capotostobnl/cc-afe-hw/assembly/psc_carrier_brd_BOM.ods

zuPSC Carrier Board
Parts Per Board |  | 216
Total Parts Cost |  | $304.54
Line Number | Qty per Board | Unit Cost | Cost Per Board | Part Number | Reference | Value | Description | Manufacturer
1 | 4 | $6.06 | $24.24 | LT3045EDD#TRPBF | U7,U8,U9,U10 |  | IC REG LIN POS ADJ 500MA 10DFN | Analog Devices
2 | 4 | $2.01 | $8.04 | LT6106CS5#TRMPBF | U4,U5,U21,U22 |  | IC CURR SENSE 1 CIRCUIT TSOT23-5 | Analog Devices
3 | 2 | $6.46 | $12.92 | LT3015EQ-15#PBF | U3,U20 |  | IC REG LINEAR -15V 1.5A DDPAK-5 | Analog Devices
4 | 2 | $5.57 | $11.14 | LT1963AEQ#TRPBF | U2,U19 |  | IC REG LIN POS ADJ 1.5A DDPAK-5 | Analog Devices
5 | 4 | $0.00 | $0.00 | BNL | U15,U16,U17,U18 |  | Burden Resistor Daughterboard | BNL
6 | 3 | $9.38 | $28.14 | LTC2991CMS#TRPBF | U12,U13,U14 |  | IC MONITOR OCTAL 16MSOP | Analog Devices
7 | 1 | $0.37 | $0.37 | CD74HC4050PWR | U23 |  | IC BUFFER NON-INVERT 6V 16-TSSOP | TI
8 | 1 | $9.56 | $9.56 | LT8643SEV#PBF | U11 |  | IC REG BUCK ADJ 6A 24LQFN | Analog Devices
9 | 1 | $5.79 | $5.79 | LT3015EDD#PBF | U6 |  | IC REG LINEAR NEG ADJ 1.5A 8-DFN | Analog Devices
10 | 1 | $1.78 | $1.78 | 3-641215-6 | U1 |  | CONN HEADER VERT 6POS 2.54MM | TE
11 | 8 | $0.23 | $1.84 | RCS-0C | TP12,TP13,TP14,TP15,TP16,TP17,TP18,TP19 |  | PC TEST POINT NATURAL | TE
12 | 11 | $0.00 | $0.00 | N/A | TP1,TP2,TP3,TP4,TP5,TP6,TP7,TP8,TP9,TP10,TP11 |  | TEST POINT | N/A
13 | 6 | $0.01 | $0.06 | ERJ-2RKF4991X | R9,R10,R48,R49,R58,R59 | 4.99K | RES SMD 4.99K OHM 1% 1/10W 0402 | Panasonic
14 | 11 | $0.01 | $0.11 | ERJ-2RKF1002X | R60,R61,R62,R63,R64,R65,R66,R67,R68,R69,R70 | 10K | RES SMD 9.53K OHM 1% 1/10W 0402 | Panasonic
15 | 3 | $0.01 | $0.03 | ERJ-2RKF9531X | R42,R44,R46 | 9.53K | RES SMD 9.53K OHM 1% 1/10W 0402 | Panasonic
16 | 4 | $0.71 | $2.84 | KRL6432E-M-R010-F-T1 | R4,R7,R53,R56 | 0.01 | RES 0.01 OHM 3W 2512 WIDE | Susumu
17 | 6 | $0.01 | $0.06 | ERJ-2RKF9091X | R36,R38,R40,R43,R45,R47 | 9.09K | RES SMD 9.09K OHM 1% 1/10W 0402 | Panasonic
18 | 2 | $0.01 | $0.02 | ERJ-2RKF4701X | R31,R32 | 4.7K | RES SMD 4.7K OHM 1% 1/10W 0402 | Panasonic
19 | 8 | $0.01 | $0.08 | ERJ-2RKF1000X | R3,R5,R6,R8,R52,R54,R55,R57 | 100 | RES SMD 100 OHM 1% 1/10W 0402 | Panasonic
20 | 2 | $0.01 | $0.02 | ERJ-2RKF1022X | R29,R35 | 10.2K | RES SMD 10.2K OHM 1% 1/10W 0402 | Panasonic
21 | 7 | $0.01 | $0.07 | ERJ-2RKF1001X | R2,R16,R27,R37,R39,R41,R51 | 1.0K | RES SMD 1K OHM 1% 1/10W 0402 | Panasonic
22 | 5 | $0.38 | $1.90 | KRL2012E-M-R220-F-T5 | R13,R14,R19,R22,R25 | 0.22 | RES 0.22 OHM 1W 0805 WIDE | Susumu
23 | 5 | $0.01 | $0.05 | ERJ-2GE0R00X | R11,R17,R20,R23,R33 | 0 | RES SMD 0 OHM JUMPER 1/10W 0402 | Panasonic
24 | 3 | $0.01 | $0.03 | ERJ-2RKF1152X | R1,R15,R50 | 11.5K | ERJ-2RKF1152X | Panasonic
25 | 1 | $0.01 | $0.01 | ERJ-2RKF1600X | R71 | 160 | RES SMD 160 OHM 1% 1/10W 0402 | Panasonic
26 | 1 | $0.01 | $0.01 | ERJ-2RKF4222X | R34 | 42.2K | RES SMD 42.2K OHM 1% 1/10W 0402 | Panasonic
27 | 1 | $0.01 | $0.01 | ERJ-2RKF1131X | R30 | 1.13K | RES SMD 1.13K OHM 1% 1/10W 0402 | Panasonic
28 | 1 | $0.01 | $0.01 | ERJ-2RKF8451X | R28 | 8.45K | RES SMD 8.45K OHM 1% 1/10W 0402 | Panasonic
29 | 1 | $0.01 | $0.01 | ERJ-2RKF4122X | R26 | 41.2K | RES SMD 41.2K OHM 1% 1/10W 0402 | Panasonic
30 | 1 | $0.01 | $0.01 | ERJ-2RKF2492X | R24 | 24.9K | RES SMD 24.9K OHM 1% 1/10W 0402 | Panasonic
31 | 1 | $0.01 | $0.01 | ERJ-2RKF1802X | R21 | 18.0K | RES SMD 18K OHM 1% 1/10W 0402 | Panasonic
32 | 1 | $0.01 | $0.01 | ERJ-2RKF3322X | R18 | 33.2K | RES SMD 33.2K OHM 1% 1/10W 0402 | Panasonic
33 | 1 | $0.01 | $0.01 | ERJ-2RKF5362X | R12 | 53.6K | RES SMD 53.6K OHM 1% 1/10W 0402 | Panasonic
34 | 1 | $0.10 | $0.10 | NX7002BKWX | Q1 |  | MOSFET N-CH 60V 270MA SOT323 | Nexperia
35 | 5 | $0.01 | $0.05 | LSMGG160808T331RG | L1,L2,L3,L4,L5 |  | FERRITE BEAD 330 OHM 0603 1LN | Taiyo Yuden
36 | 1 | $3.26 | $3.26 | MSS1048-222NLC | L6 | 2.2uF | FIXED IND 2.2UH 9.78A 7.2MOHM SM | Coilcraft
37 | 4 | $17.82 | $71.28 | 836149012 | J8,J11,J14,J17 |  | CONN MICRO-D PLUG 25POS R/A SLDR | Molex
38 | 8 | $2.81 | $22.48 | 61083-061402LF | J5,J6,J9,J10,J12,J13,J15,J16 |  | CONN PLUG 60POS SMD GOLD | Amphenol
39 | 3 | $17.37 | $52.11 | 6469028-1 | J1,J2,J3 |  | CONN RCPT HIGH SPEED 60P EDGE MT | TE
40 | 1 | $24.50 | $24.50 | 1731130154 | J7 |  | CONN D-SUB HD PLG 26POS R/A SLDR | Molex
41 | 1 | $1.25 | $1.25 | 39301022 | J4 |  | CONN HEADER R/A 2POS | Molex
42 | 2 | $0.77 | $1.54 | ASMDC300F/24-2 | F1,F2 |  | PTC RESET FUSE 24V 3A 2SMD | Littlefuse
43 | 2 | $0.10 | $0.20 | LTST-C191KGKT | D1,D3 | GREEN | LED GREEN CLEAR SMD | Lite-On Inc.
44 | 4 | $3.56 | $14.24 | T521X107M025ATE060 | C7,C8,C66,C67 | 100uF | CAP TANT POLY 100UF 25V 2917 | Kemet
45 | 4 | $0.04 | $0.16 | CL21A226MAYNNNE | C53,C54,C55,C56 | 22uF | CAP CER 22UF 25V X5R 0805 | Samsung
46 | 28 | $0.01 | $0.28 | TMK105BJ104KV-F | C5,C6,C10,C12,C13,C14,C15,C19,C21,C23,C24,C30,C31,C36,C37,C42,C43,C57,C58,C59,C64,C65,C69,C71,C72,C73,C74,C75 | 0.1uF | CAP CER 0.1UF 25V X5R 0402 | Taiyo Yuden
47 | 2 | $0.01 | $0.02 | CL10C100JB8NFNC | C48,C52 | 10pF | CAP CER 10PF 50V C0G/NP0 0603 | Samsung
48 | 25 | $0.04 | $1.00 | CL10A106MA8NRNC | C3,C4,C9,C11,C16,C17,C18,C20,C22,C25,C28,C29,C32,C34,C35,C38,C40,C41,C44,C47,C49,C62,C63,C68,C70 | 10uF | CAP CER 10UF 25V X5R 0603 | Samsung
49 | 5 | $0.22 | $1.10 | GRM31CR61A107MEA8L | C26,C27,C33,C39,C45 | 100uF | CAP CER 100UF 10V X5R 1206 | Murata
50 | 4 | $0.44 | $1.76 | EEE-FTH101XAP | C1,C2,C60,C61 | 100uF | CAP ALUM 100UF 20% 50V SMD | Panasonic
51 | 1 | $0.01 | $0.01 | CL10B105KA8NNNC | C51 | 1uF | CAP CER 1UF 25V X7R 0603 | Samsung
52 | 1 | $0.01 | $0.01 | CL10B331KB8NNNC | C50 | 330pF | CAP CER 330PF 50V X7R 0603 | Samsung
53 | 1 | $0.01 | $0.01 | CL10B223KB8NNNC | C46 | 0.022uF | CAP CER 0.022UF 50V X7R 0603 | Samsung
