capotostobnl/cc-afe-hw/3dmodels/ADR3425ARJZ-R2.step

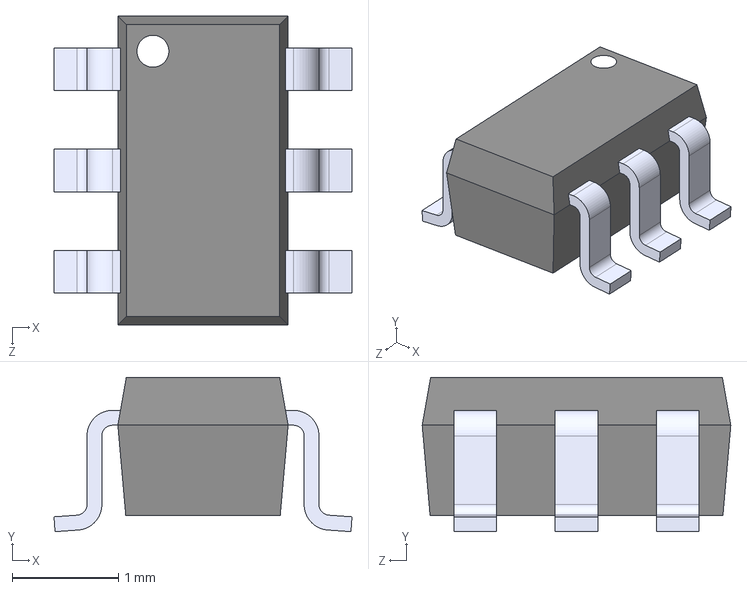
[picture p1: CAD file, 2026-06-05]
3dmodels/ADR3425ARJZ-R2.step
2.80 x 1.45 x 2.90 mm
