capotostobnl/cc-afe-hw/3dmodels/c-1625854-1-ba-3d.step

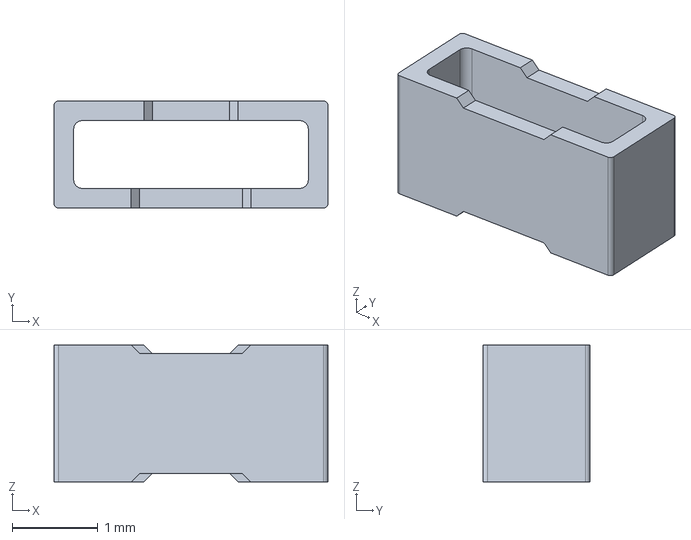
[picture p3: CAD file, 2026-06-02]
3dmodels/c-1625854-1-ba-3d.step
3.20 x 1.25 x 1.60 mm
