capotostobnl/cc-afe-hw/3dmodels/KRL2012E-M-R220-F-T5.step

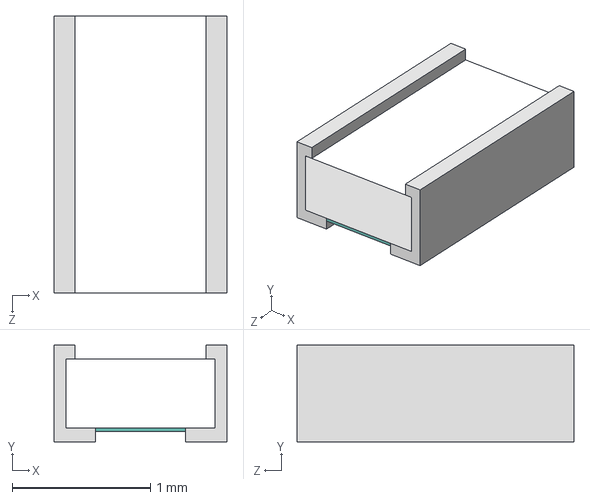
[picture p5: CAD file, 2026-06-02]
3dmodels/KRL2012E-M-R220-F-T5.step
1.25 x 0.7 x 2.00 mm
