capotostobnl/cc-afe-hw/3dmodels/SN74LVC16T245DGGR.STEP

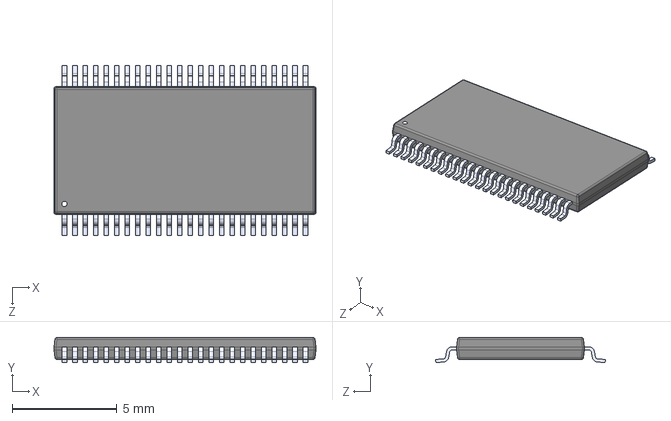
[picture p6: CAD file, 2026-06-02]
3dmodels/SN74LVC16T245DGGR.STEP
12.5 x 1.20 x 8.10 mm
