capotostobnl/cc-afe-hw/3dmodels/0875-1G2T-E3.STEP

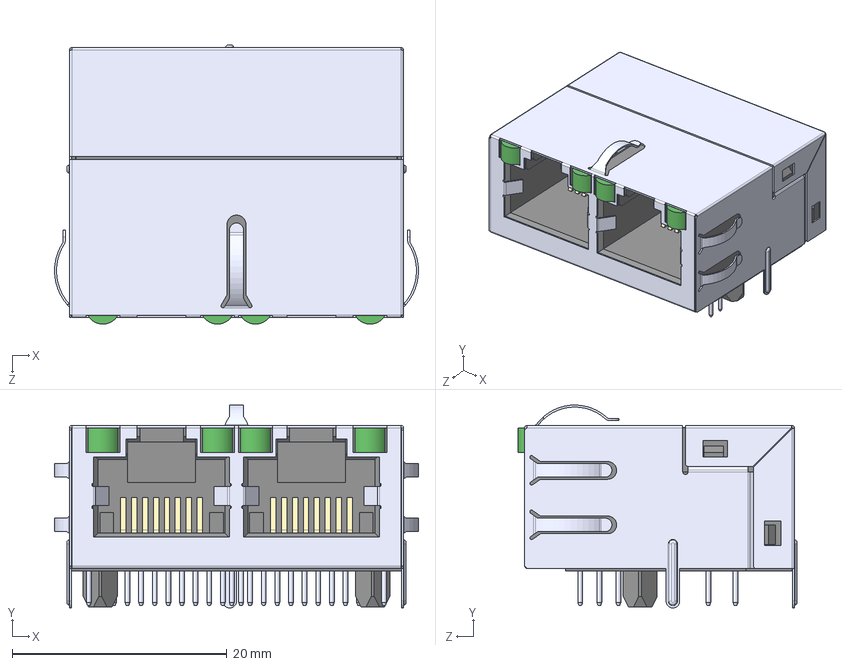
[picture p7: CAD file, 2026-06-02]
3dmodels/0875-1G2T-E3.STEP
33.9 x 18.9 x 26.0 mm
