capotostobnl/cc-afe-hw/3dmodels/TPS3850H33DRCR.STEP

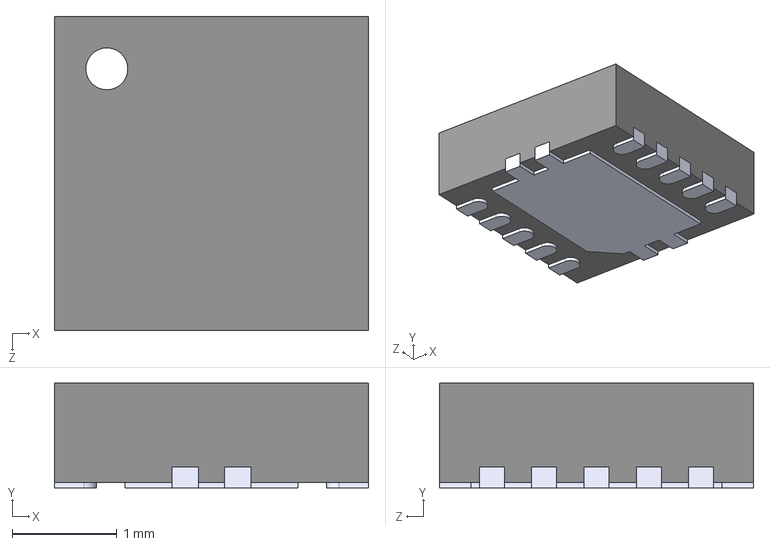
[picture p8: CAD file, 2026-06-02]
3dmodels/TPS3850H33DRCR.STEP
3.00 x 1.00 x 3.00 mm
