capotostobnl/cc-afe-hw/3dmodels/LTC2991CMS_TRPBF.step

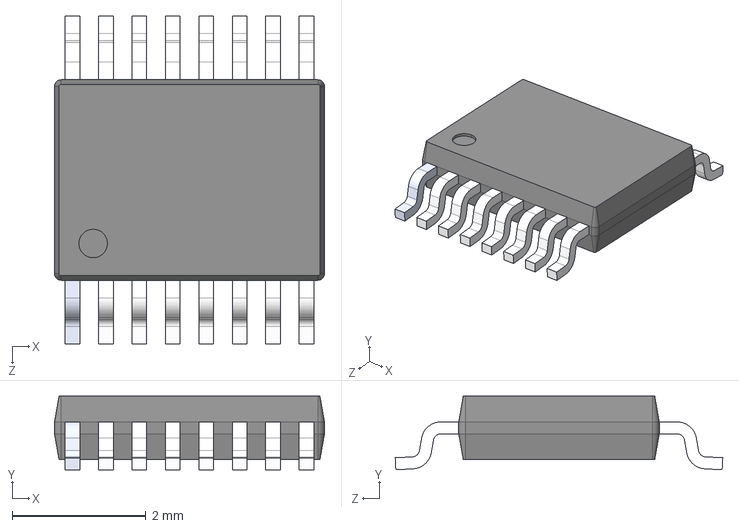
[picture p9: CAD file, 2026-06-02]
3dmodels/LTC2991CMS_TRPBF.step
4.04 x 1.10 x 4.90 mm
