capotostobnl/cc-afe-hw/3dmodels/LEMO_EPY_00_250_NTN.stp

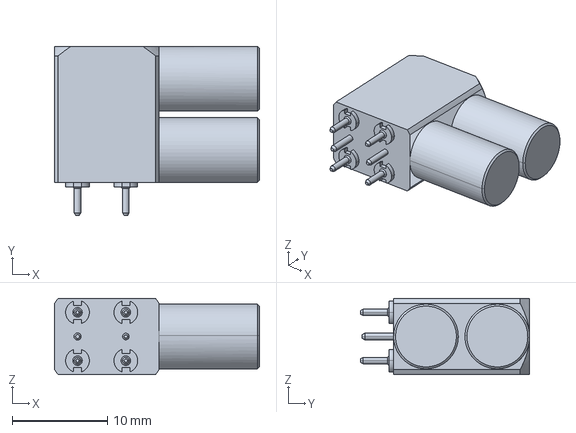
[picture p10: CAD file, 2026-06-02]
3dmodels/LEMO_EPY_00_250_NTN.stp
21.6 x 17.8 x 8.00 mm
