capotostobnl/cc-afe-hw/3dmodels/CB3LV-3I-25M0000.step

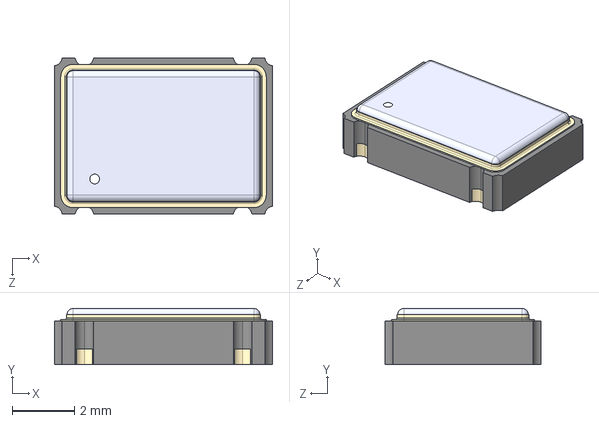
[picture p11: CAD file, 2026-06-02]
3dmodels/CB3LV-3I-25M0000.step
7.00 x 1.80 x 5.00 mm
