capotostobnl/cc-afe-hw/3dmodels/RES_6432_SUS.step

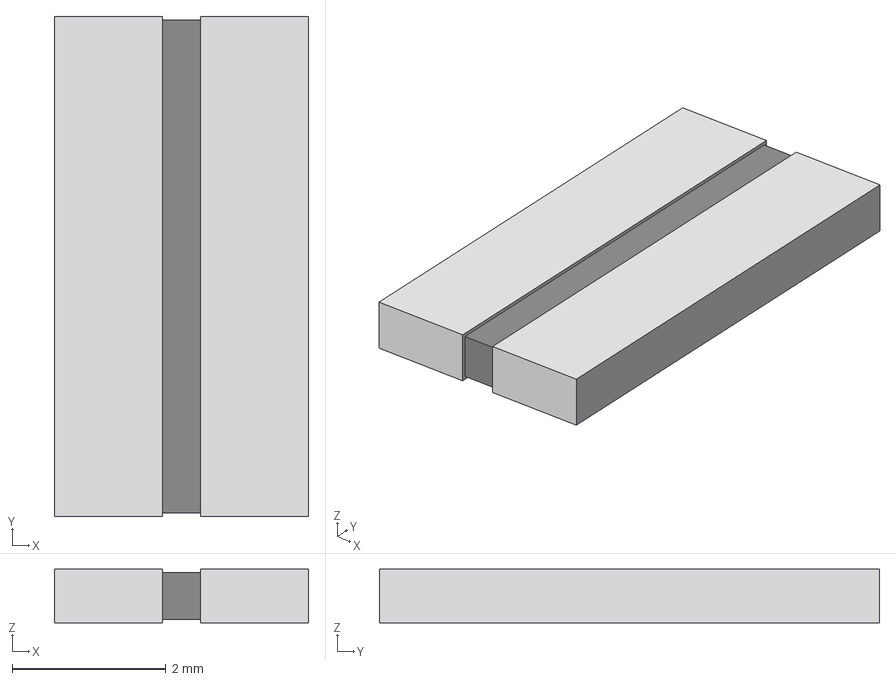
[picture p12: CAD file, 2026-06-02]
3dmodels/RES_6432_SUS.step
3.30 x 6.50 x 0.7 mm
