capotostobnl/cc-afe-hw/3dmodels/MSOP-8_MS_LIT.step

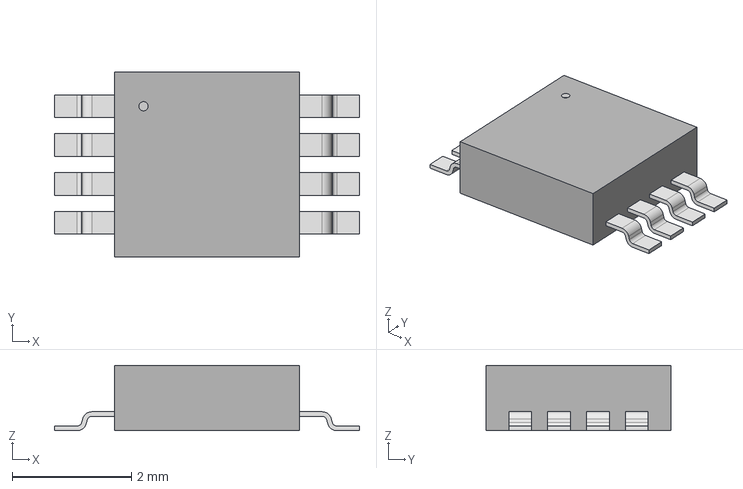
[picture p13: CAD file, 2026-06-02]
3dmodels/MSOP-8_MS_LIT.step
5.11 x 3.10 x 1.09 mm
