capotostobnl/cc-afe-hw/3dmodels/SN74LVC8T245DWR.step

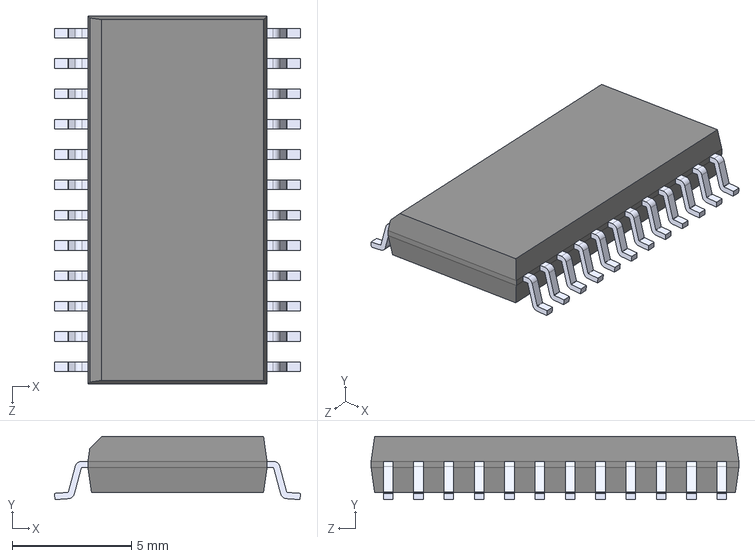
[picture p14: CAD file, 2026-06-02]
3dmodels/SN74LVC8T245DWR.step
10.3 x 2.65 x 15.4 mm
