capotostobnl/cc-afe-hw/3dmodels/3-641215-6-z-3d.step

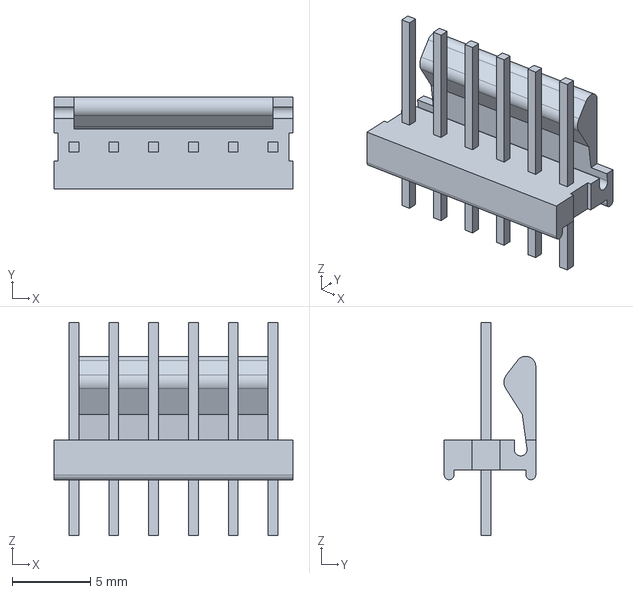
[picture p15: CAD file, 2026-06-02]
3dmodels/3-641215-6-z-3d.step
15.2 x 5.84 x 13.6 mm
