capotostobnl/cc-afe-hw/3dmodels/Coilcraft-MSS1048.step

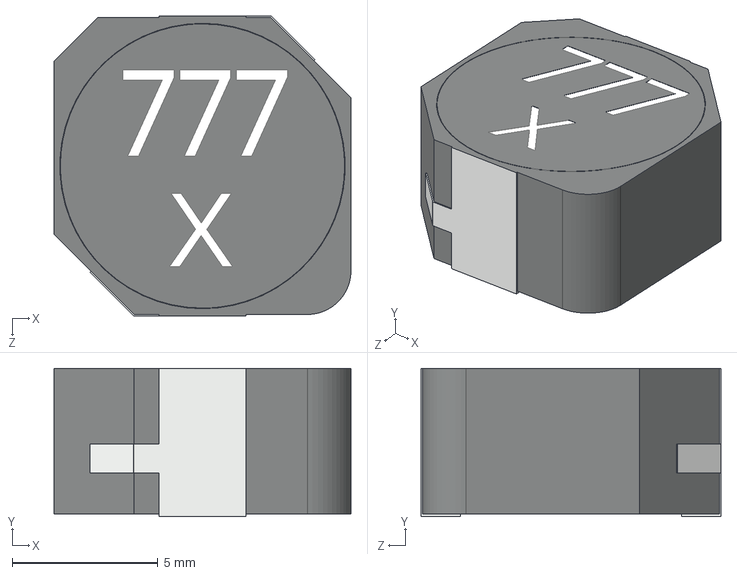
[picture p16: CAD file, 2026-06-02]
3dmodels/Coilcraft-MSS1048.step
10.2 x 5.10 x 10.3 mm
