capotostobnl/cc-afe-hw/3dmodels/Amphenol_10090926-P264XLF.step

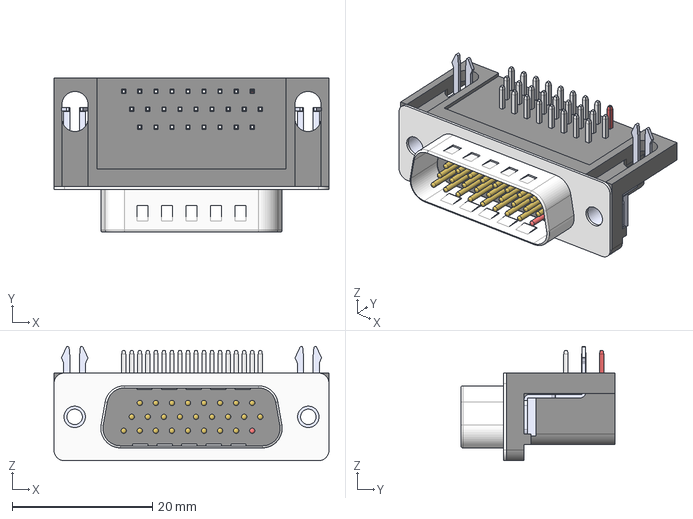
[picture p17: CAD file, 2026-06-02]
3dmodels/Amphenol_10090926-P264XLF.step
39.2 x 22.0 x 16.3 mm
