capotostobnl/cc-afe-hw/3dmodels/RDM0023A.stp

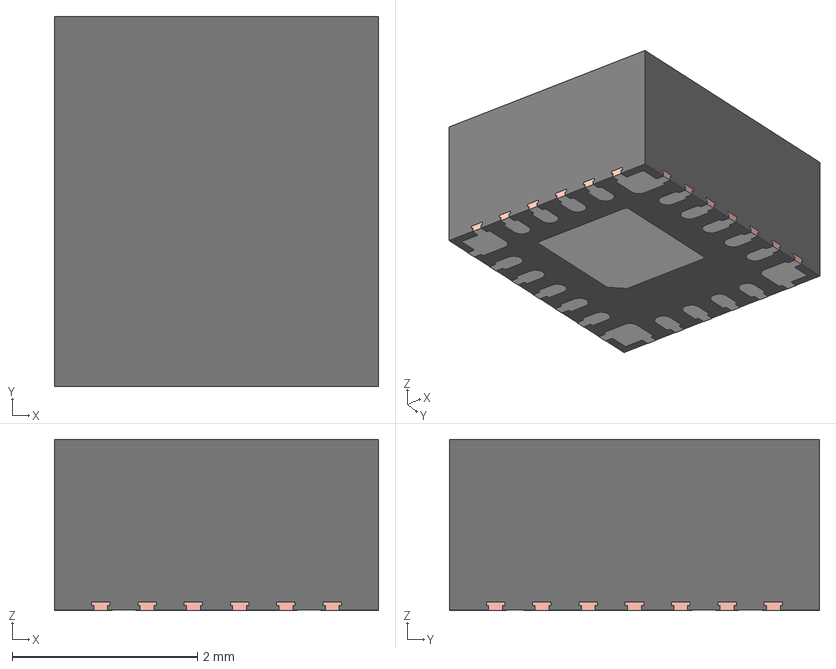
[picture p18: CAD file, 2026-06-02]
3dmodels/RDM0023A.stp
3.50 x 4.00 x 1.85 mm
FRAME
MOLD
