capotostobnl/cc-afe-hw/3dmodels/T521X107M025ATE060.step

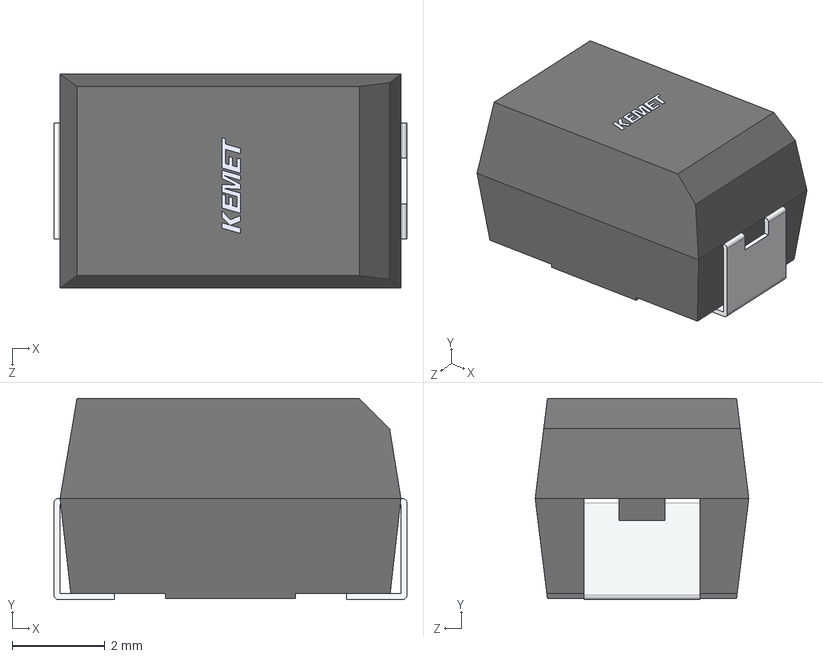
[picture p19: CAD file, 2026-06-02]
3dmodels/T521X107M025ATE060.step
7.60 x 4.34 x 4.60 mm
