capotostobnl/cc-afe-hw/3dmodels/ECS-LVDS33-2000-BN.STEP

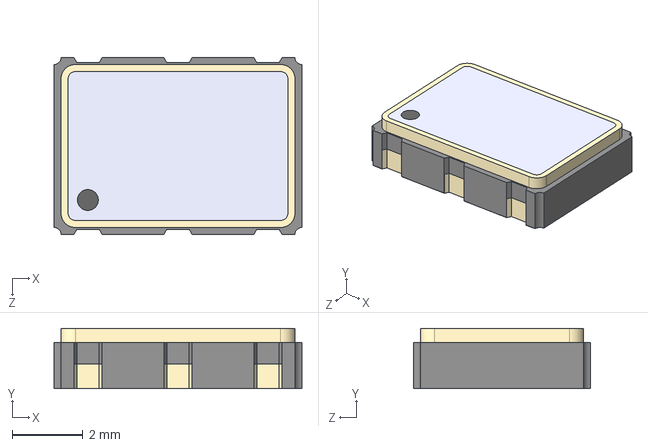
[picture p20: CAD file, 2026-06-02]
3dmodels/ECS-LVDS33-2000-BN.STEP
7.00 x 1.70 x 5.00 mm
