capotostobnl/cc-afe-hw/3dmodels/TPS7A8500RGRT.STEP

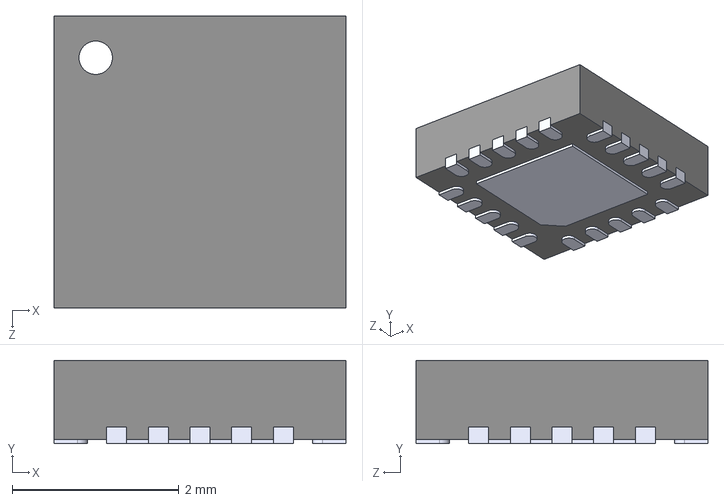
[picture p21: CAD file, 2026-06-02]
3dmodels/TPS7A8500RGRT.STEP
3.50 x 1.00 x 3.50 mm
