capotostobnl/cc-afe-hw/3dmodels/LT3015EDDPBF.step

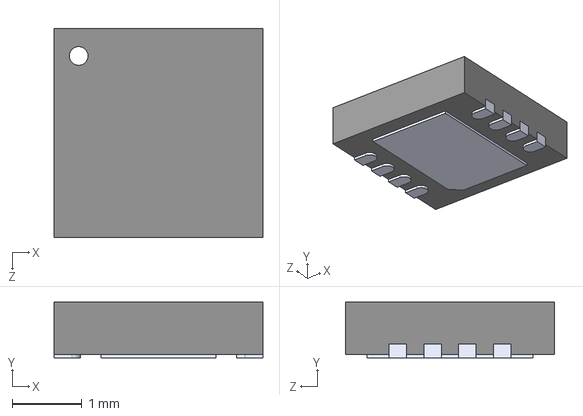
[picture p22: CAD file, 2026-06-02]
3dmodels/LT3015EDDPBF.step
3.00 x 0.8 x 3.00 mm
