capotostobnl/cc-afe-hw/3dmodels/PW0016A.step

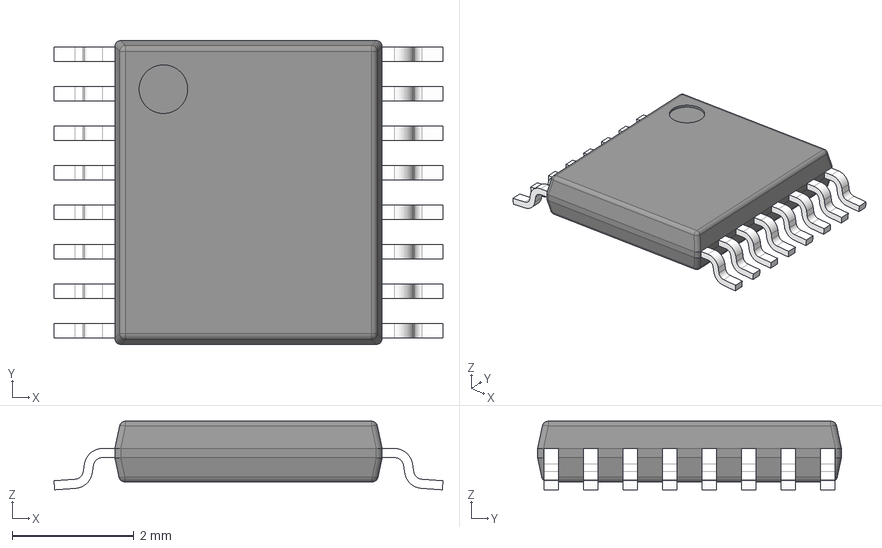
[picture p23: CAD file, 2026-06-02]
3dmodels/PW0016A.step
6.40 x 5.00 x 1.13 mm
BODY-TSSOP
LEAD-TSSOP x 16
PIN1
