capotostobnl/cc-afe-hw/3dmodels/IND_LSMG_160808_TAY.step

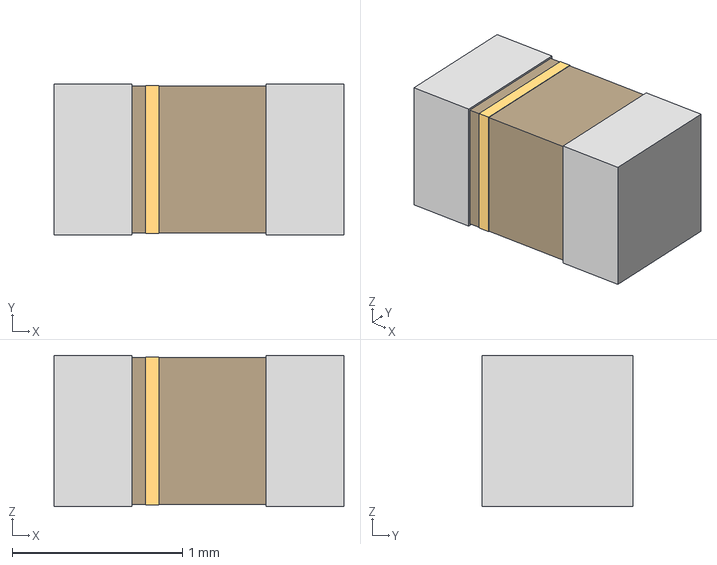
[picture p24: CAD file, 2026-06-02]
3dmodels/IND_LSMG_160808_TAY.step
1.70 x 0.888 x 0.889 mm
