capotostobnl/cc-afe-hw/3dmodels/AD5754BREZ.STEP

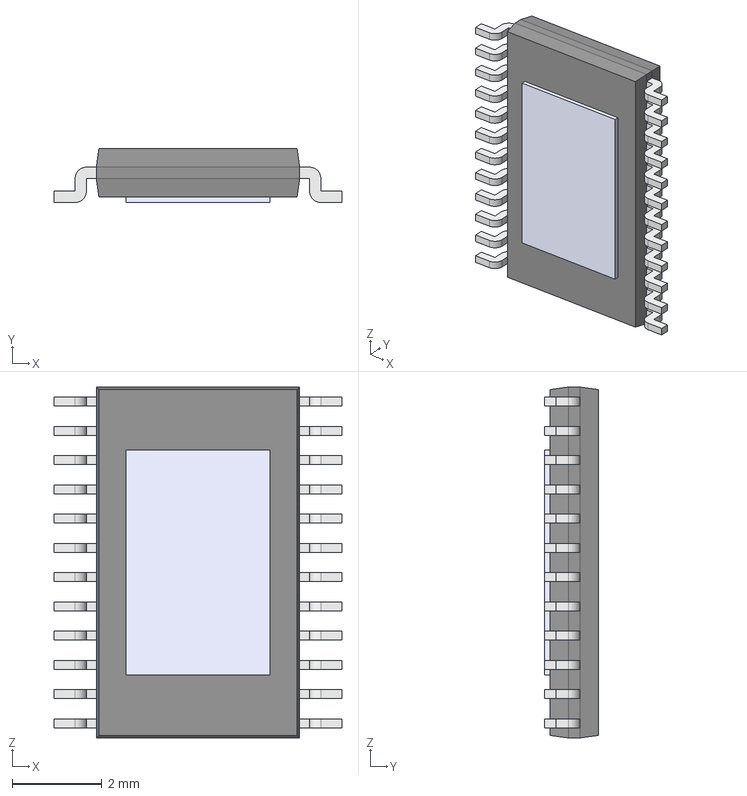
[picture p25: CAD file, 2026-06-02]
3dmodels/AD5754BREZ.STEP
6.40 x 1.20 x 7.80 mm
Body001 (Mirror #1) x 12
XY-plane x 12
X-axis x 12
