capotostobnl/cc-afe-hw/cc-afe.kicad_pcb

## KiCad design cc-afe.kicad_pcb (2026-06-05)

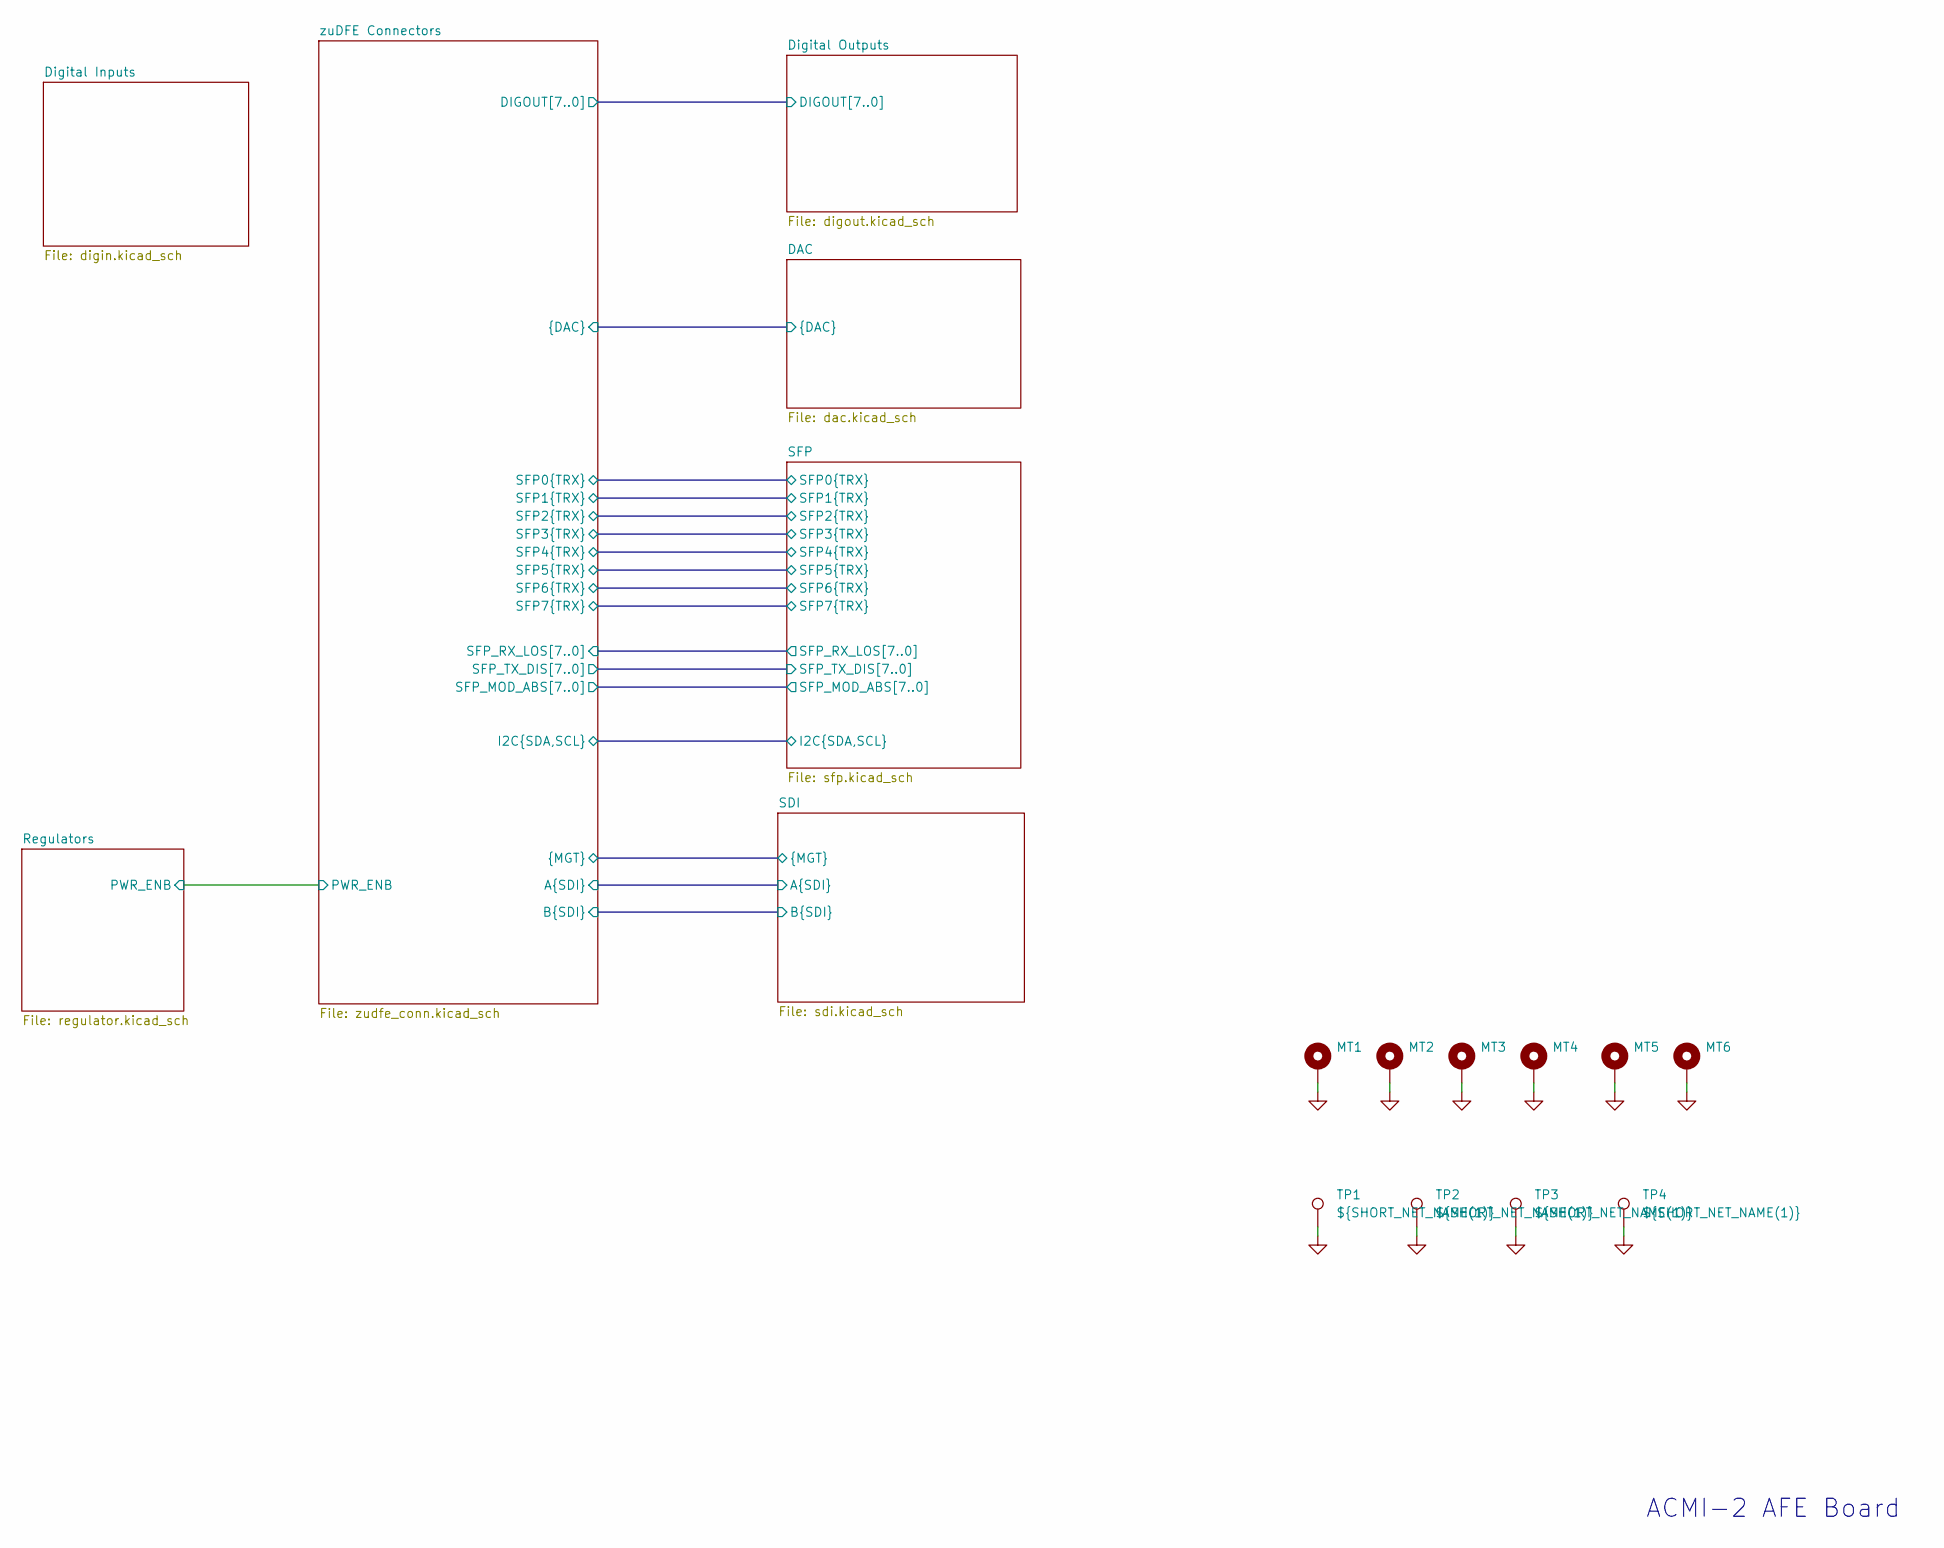
[picture p26: schematic cc-afe.kicad_sch]

Parts:
MT1, MT2, MT3, MT4, MT5, MT6: MountingHole_Pad; MountingHole_4.3mm_M4_DIN965_Pad
TP1, TP2, TP3, TP4: ${SHORT_NET_NAME(1)}; TestPoint_RCS-0C; MFG_PN RCS-0C

Connections:
GND: MT1.1, MT2.1, MT3.1, MT4.1, MT5.1, MT6.1, TP1.1, TP2.1, TP3.1, TP4.1; also elsewhere on the board

Notes on the sheet:
ACMI-2 AFE Board

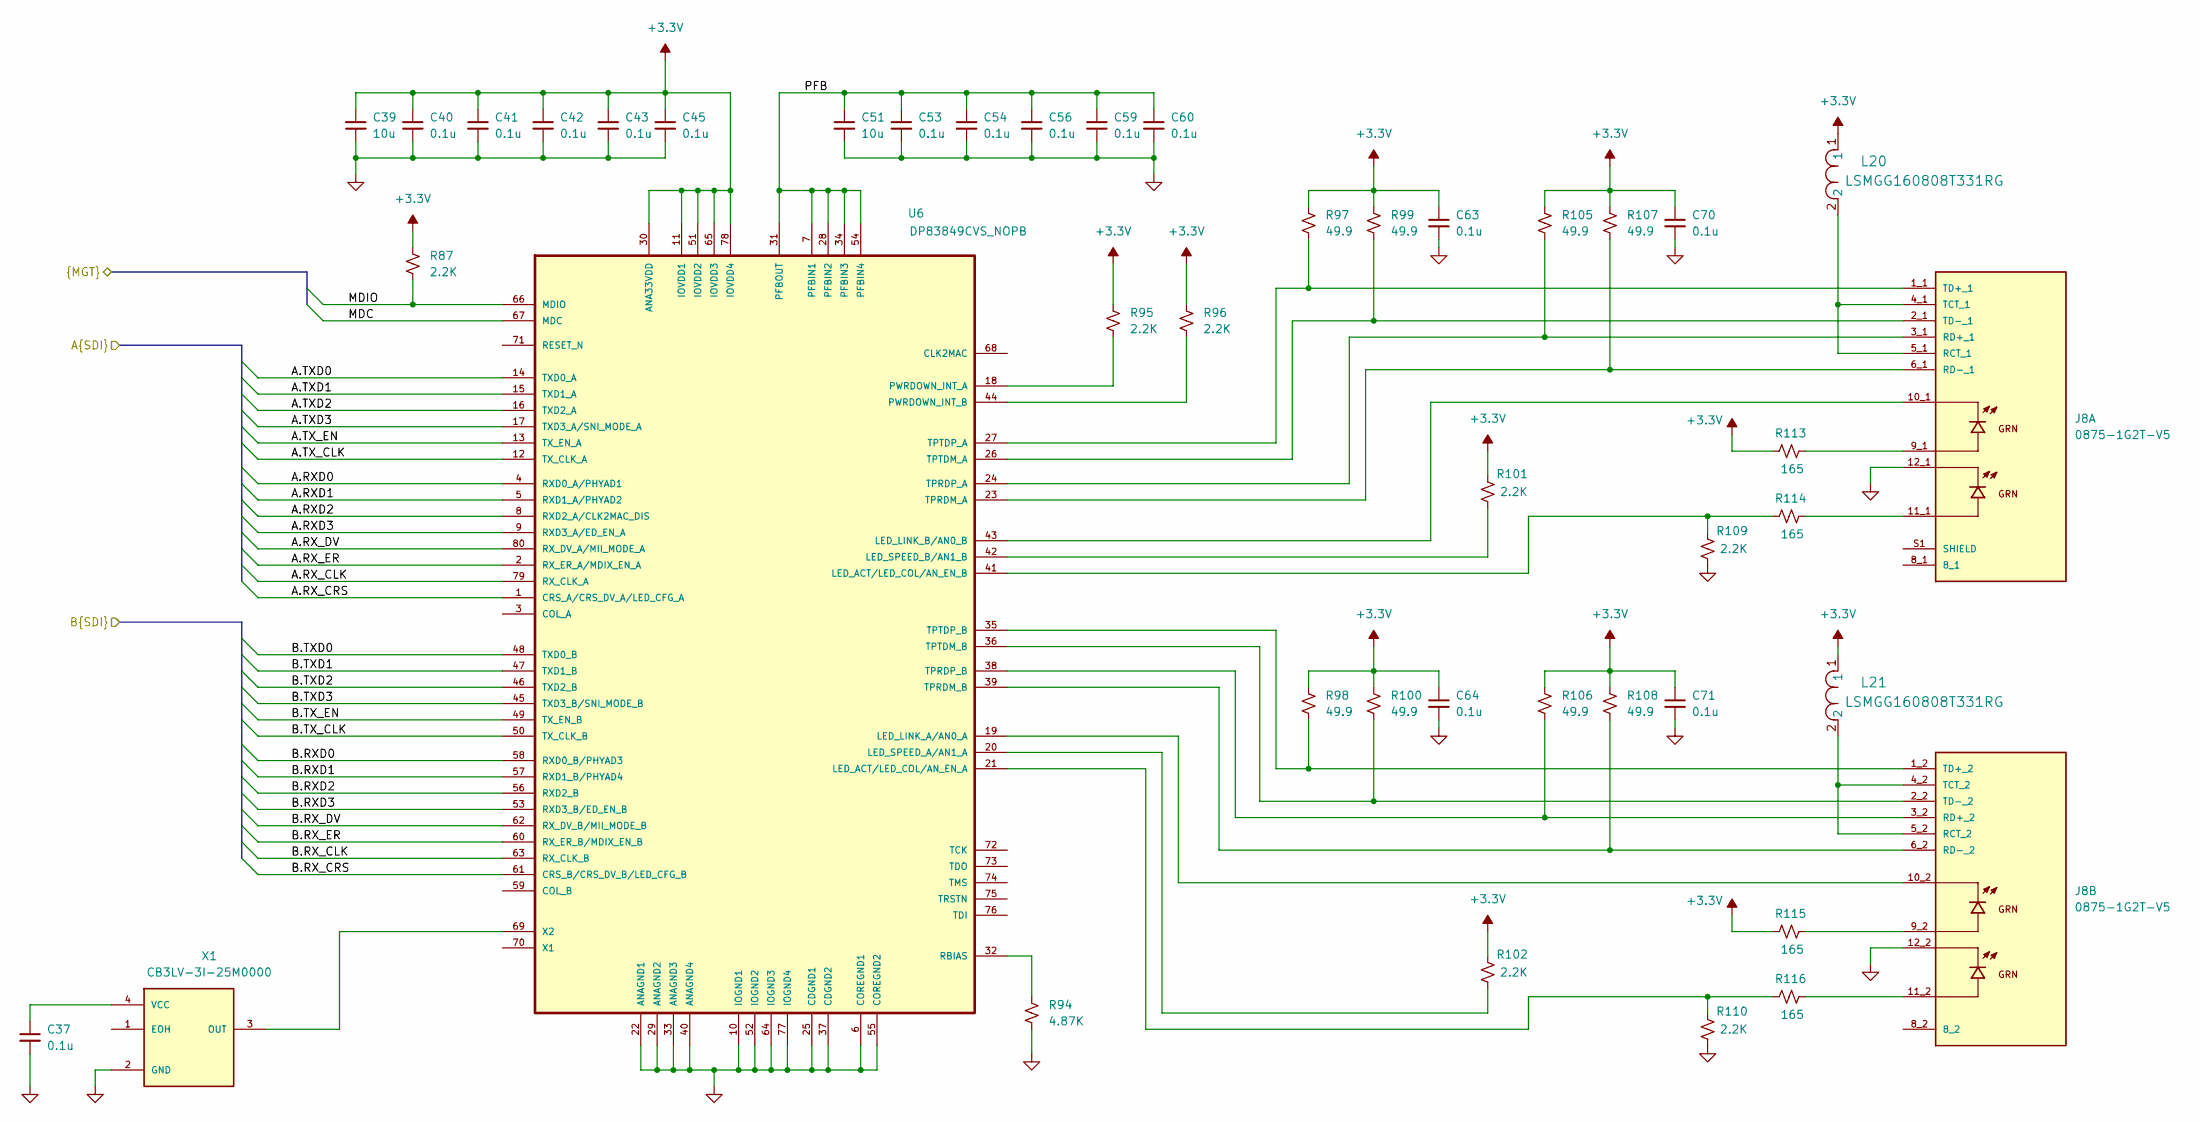
[picture p27: schematic sdi.kicad_sch]

Parts:
C37, C40, C41, C42, C43, C45, C53, C54, C56, C59, C60, C63, C64, C70, C71: 0.1u; C_0603_1608Metric; Voltage 50; MFG_PN GCJ188R71H104KA12D
C39, C51: 10u; C_0805_2012Metric; MFG_PN GRM21BR61C106KE15K
J8: 0875-1G2T-V5; BEL_0875-1G2T-V5
L20, L21: LSMGG160808T331RG; IND_LSMG_160808_TAY; MFG_PN LSMGG160808T331RG
R87, R95, R96: 2.2K; R_0603_1608Metric; MFG_PN ERJ-3EKF49R9V
R94: 4.87K; R_0603_1608Metric
R97, R98, R99, R100, R105, R106, R107, R108: 49.9; R_0603_1608Metric; MFG_PN ERJ-3EKF49R9V
R101, R102, R109, R110: 2.2K; R_0603_1608Metric
R113, R114, R115, R116: 165; R_0603_1608Metric
U6: DP83849CVS_NOPB; QFP50P1400X1400X120-80N; MFG_PN DP83849CVS/NOPB
X1: CB3LV-3I-25M0000; OSCCC700X500X180-4N; MFG_PN CB3LV-3I-25M0000

Connections:
+3.3V: C39.1, C40.1, C41.1, C42.1, C43.1, C45.1, C63.1, C64.1, C70.1, C71.1, L20.1, L21.1, R87.1, R95.1, R96.1, R97.1, R98.1, R99.1, R100.1, R101.2, R102.2, R105.1, R106.1, R107.1, R108.1, R113.1, R115.1, U6.11 (IOVDD1), U6.30 (ANA33VDD), U6.51 (IOVDD2), U6.65 (IOVDD3), U6.78 (IOVDD4); also elsewhere on the board
/SDI/A.RXD0: U6.4 (RXD0_A/PHYAD1); also elsewhere on the board
/SDI/A.RXD1: U6.5 (RXD1_A/PHYAD2); also elsewhere on the board
/SDI/A.RXD2: U6.8 (RXD2_A/CLK2MAC_DIS); also elsewhere on the board
/SDI/A.RXD3: U6.9 (RXD3_A/ED_EN_A); also elsewhere on the board
/SDI/A.RX_CLK: U6.79 (RX_CLK_A); also elsewhere on the board
/SDI/A.RX_CRS: U6.1 (CRS_A/CRS_DV_A/LED_CFG_A); also elsewhere on the board
/SDI/A.RX_DV: U6.80 (RX_DV_A/MII_MODE_A); also elsewhere on the board
/SDI/A.RX_ER: U6.2 (RX_ER_A/MDIX_EN_A); also elsewhere on the board
/SDI/A.TXD0: U6.14 (TXD0_A); also elsewhere on the board
/SDI/A.TXD1: U6.15 (TXD1_A); also elsewhere on the board
/SDI/A.TXD2: U6.16 (TXD2_A); also elsewhere on the board
/SDI/A.TXD3: U6.17 (TXD3_A/SNI_MODE_A); also elsewhere on the board
/SDI/A.TX_CLK: U6.12 (TX_CLK_A); also elsewhere on the board
/SDI/A.TX_EN: U6.13 (TX_EN_A); also elsewhere on the board
/SDI/B.RXD0: U6.58 (RXD0_B/PHYAD3); also elsewhere on the board
/SDI/B.RXD1: U6.57 (RXD1_B/PHYAD4); also elsewhere on the board
/SDI/B.RXD2: U6.56 (RXD2_B); also elsewhere on the board
/SDI/B.RXD3: U6.53 (RXD3_B/ED_EN_B); also elsewhere on the board
/SDI/B.RX_CLK: U6.63 (RX_CLK_B); also elsewhere on the board
/SDI/B.RX_CRS: U6.61 (CRS_B/CRS_DV_B/LED_CFG_B); also elsewhere on the board
/SDI/B.RX_DV: U6.62 (RX_DV_B/MII_MODE_B); also elsewhere on the board
/SDI/B.RX_ER: U6.60 (RX_ER_B/MDIX_EN_B); also elsewhere on the board
/SDI/B.TXD0: U6.48 (TXD0_B); also elsewhere on the board
/SDI/B.TXD1: U6.47 (TXD1_B); also elsewhere on the board
/SDI/B.TXD2: U6.46 (TXD2_B); also elsewhere on the board
/SDI/B.TXD3: U6.45 (TXD3_B/SNI_MODE_B); also elsewhere on the board
/SDI/B.TX_CLK: U6.50 (TX_CLK_B); also elsewhere on the board
/SDI/B.TX_EN: U6.49 (TX_EN_B); also elsewhere on the board
/SDI/MDC: U6.67 (MDC); also elsewhere on the board
/SDI/MDIO: R87.2, U6.66 (MDIO); also elsewhere on the board
/SDI/PFB: C51.1, C53.1, C54.1, C56.1, C59.1, C60.1, U6.7 (PFBIN1), U6.28 (PFBIN2), U6.31 (PFBOUT), U6.34 (PFBIN3), U6.54 (PFBIN4)
GND: C37.2, C39.2, C40.2, C41.2, C42.2, C43.2, C45.2, C51.2, C53.2, C54.2, C56.2, C59.2, C60.2, C63.2, C64.2, C70.2, C71.2, J8.12_1, J8.12_2, R94.2, R109.1, R110.1, U6.6 (COREGND1), U6.10 (IOGND1), U6.22 (ANAGND1), U6.25 (CDGND1), U6.29 (ANAGND2), U6.33 (ANAGND3), U6.37 (CDGND2), U6.40 (ANAGND4), U6.52 (IOGND2), U6.55 (COREGND2), U6.64 (IOGND3), U6.77 (IOGND4), X1.2 (GND); also elsewhere on the board
unnamed: J8.9_1, R113.2
unnamed: J8.9_2, R115.2
unnamed: J8.11_1, R114.2
unnamed: J8.11_2, R116.2
unnamed: J8.4_1 (TCT_1), J8.5_1 (RCT_1), L20.2
unnamed: J8.3_1 (RD+_1), R105.2, U6.24 (TPRDP_A)
unnamed: J8.6_1 (RD-_1), R107.2, U6.23 (TPRDM_A)
unnamed: J8.S1 (SHIELD), J8.S2 (SHIELD), J8.S3 (SHIELD)
unnamed: J8.1_1 (TD+_1), R97.2, U6.27 (TPTDP_A)
unnamed: J8.2_1 (TD-_1), R99.2, U6.26 (TPTDM_A)
unnamed: J8.4_2 (TCT_2), J8.5_2 (RCT_2), L21.2
unnamed: J8.3_2 (RD+_2), R106.2, U6.38 (TPRDP_B)
unnamed: J8.6_2 (RD-_2), R108.2, U6.39 (TPRDM_B)
unnamed: J8.1_2 (TD+_2), R98.2, U6.35 (TPTDP_B)
unnamed: J8.2_2 (TD-_2), R100.2, U6.36 (TPTDM_B)
unnamed: R110.2, R116.1, U6.21 (LED_ACT/LED_COL/AN_EN_A)
unnamed: R109.2, R114.1, U6.41 (LED_ACT/LED_COL/AN_EN_B)
unnamed: J8.10_2, U6.19 (LED_LINK_A/AN0_A)
unnamed: J8.10_1, U6.43 (LED_LINK_B/AN0_B)
unnamed: R102.1, U6.20 (LED_SPEED_A/AN1_A)
unnamed: R101.1, U6.42 (LED_SPEED_B/AN1_B)
unnamed: R95.2, U6.18 (PWRDOWN_INT_A)
unnamed: R96.2, U6.44 (PWRDOWN_INT_B)
unnamed: R94.1, U6.32 (RBIAS)
unnamed: U6.69 (X2), X1.3 (OUT)
unnamed: C37.1, X1.4 (VCC)

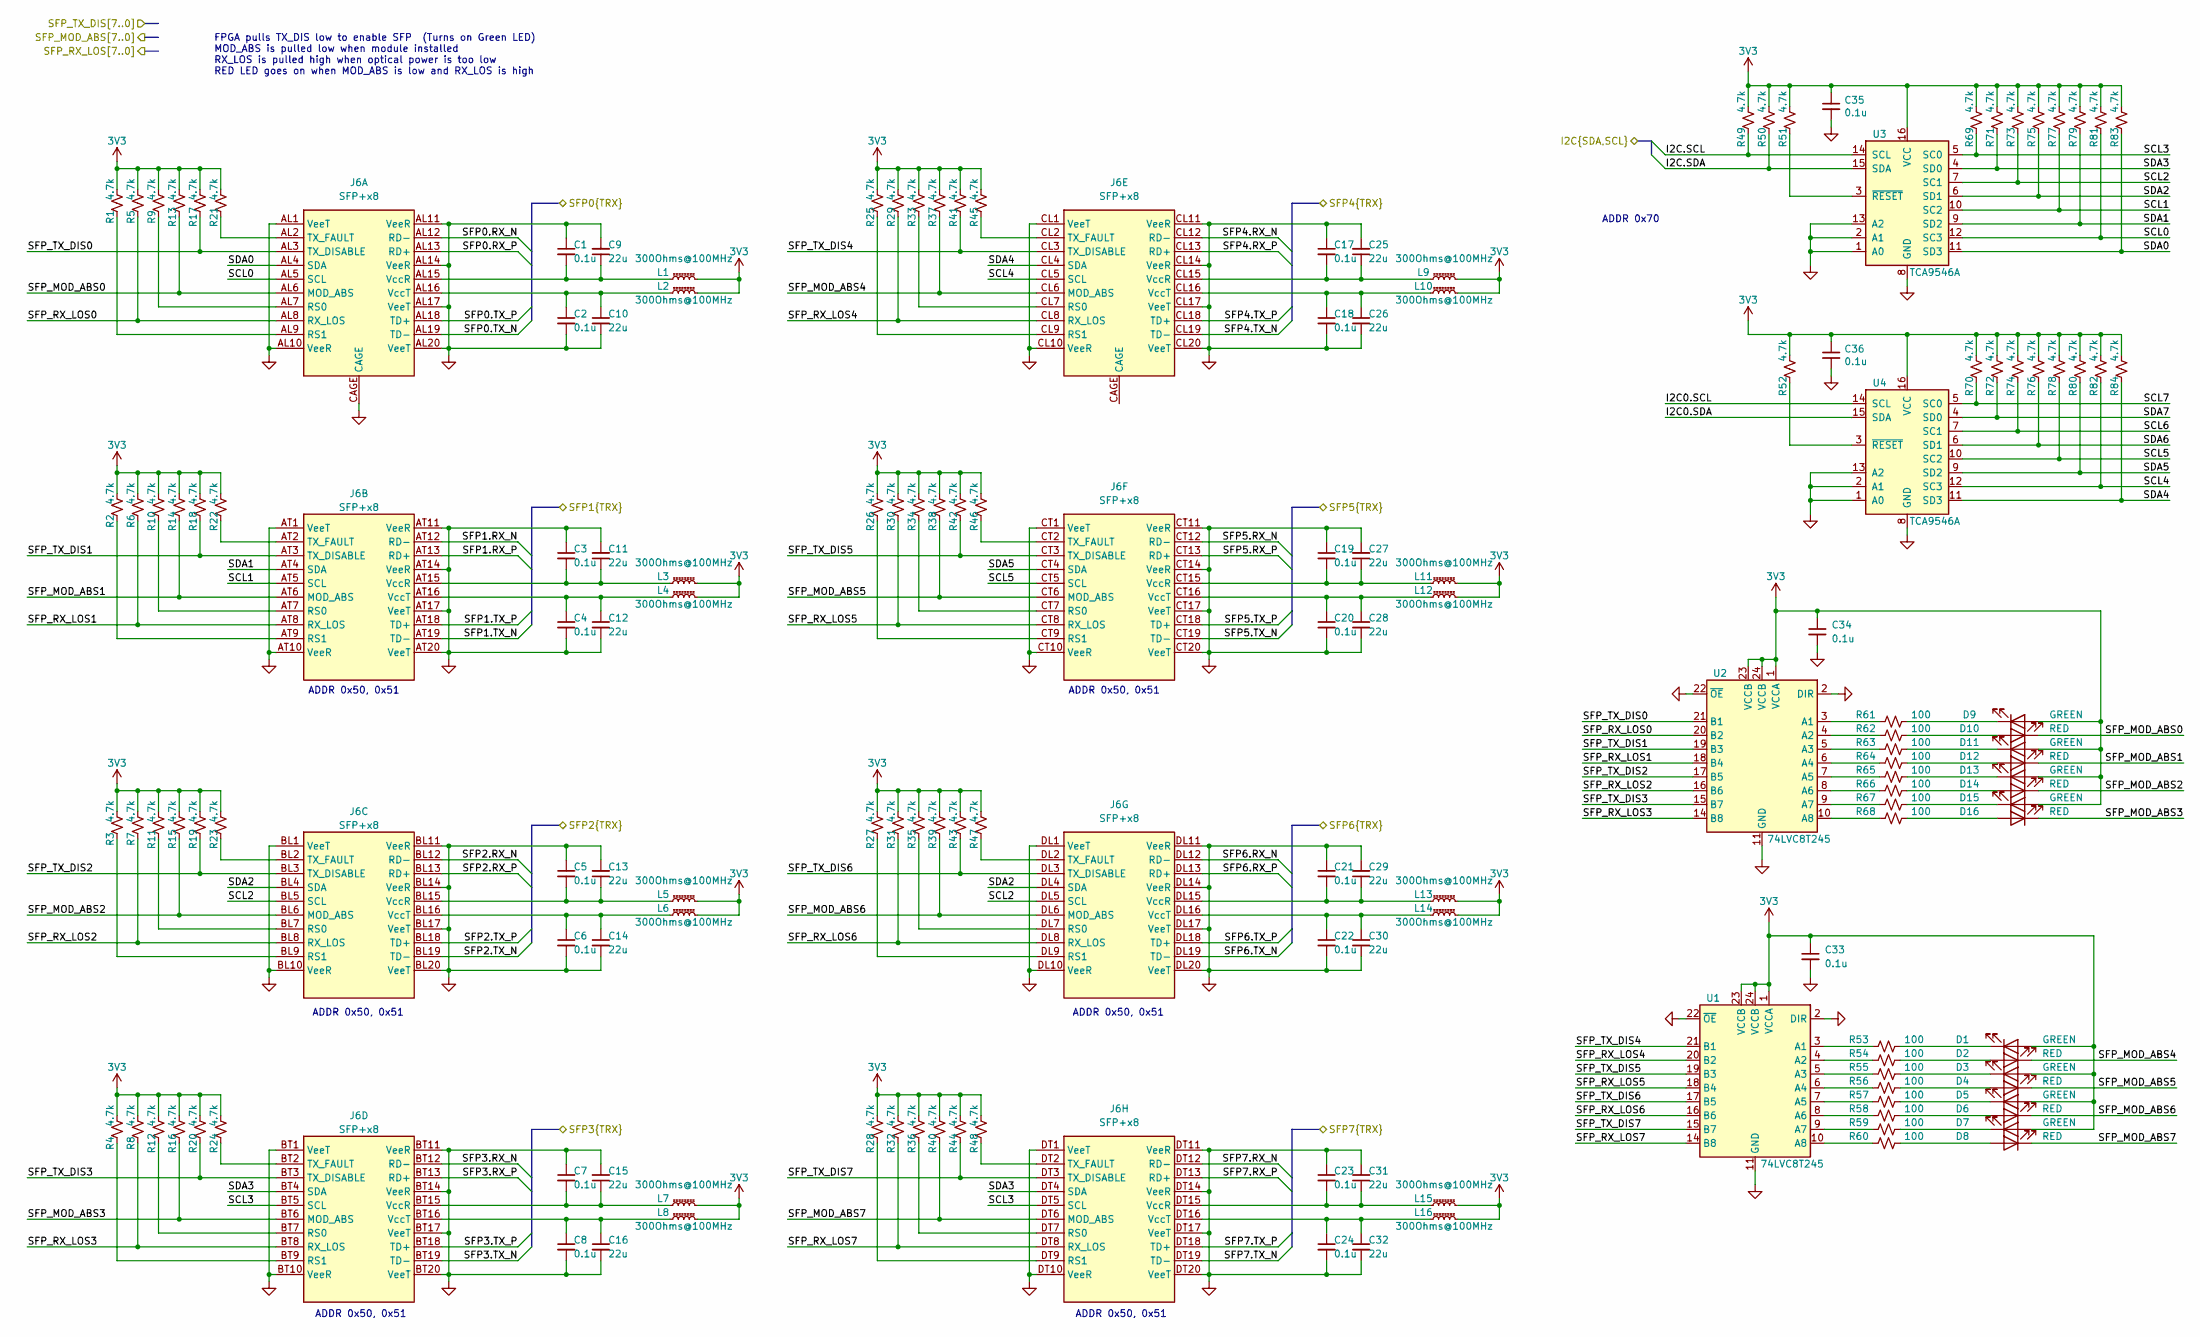
[picture p28: schematic sfp.kicad_sch, RHIC MADC2\nSCHEMATIC DRAWING]

Parts:
C1, C2, C3, C4, C5, C6, C7, C8, C17, C18, C19, C20, C21, C22, C23, C24, C33, C34, C35, C36: 0.1u; C_0603_1608Metric; MFG_PN CL10B104KB8NNNC
C9, C10, C11, C12, C13, C14, C15, C16, C25, C26, C27, C28, C29, C30, C31, C32: 22u; C_0805_2012Metric; MFG_PN CL21A226MAYNNNE
D1, D3, D5, D7, D9, D11, D13, D15: GREEN; LED_0603_1608Metric; MFG_PN LTST-C191KGKT
D2, D4, D6, D8, D10, D12, D14, D16: RED; LED_0603_1608Metric; MFG_PN LTST-C191KRKT
J6: SFP+x8; 1-2007394-5
L1, L2, L3, L4, L5, L6, L7, L8, L9, L10, L11, L12, L13, L14, L15, L16: 300Ohms@100MHz; L_0603_1608Metric; MFG_PN 742792641
R1, R2, R3, R4, R5, R6, R7, R8, R9, R10, R11, R12, R13, R14, R15, R16, R17, R18, R19, R20, R21, R22, R23, R24, R25, R26, R27, R28, R29, R30, R31, R32, R33, R34, R35, R36, R37, R38, R39, R40, R41, R42, R43, R44, R45, R46, R47, R48, R49, R50, R51, R52, R69, R70, R71, R72, R73, R74, R75, R76, R77, R78, R79, R80, R81, R82, R83, R84: 4.7k; R_0603_1608Metric; MFG_PN RMCF0603FT4K70
R53, R54, R55, R56, R57, R58, R59, R60, R61, R62, R63, R64, R65, R66, R67, R68: 100; R_0603_1608Metric; MFG_PN RMCF0603FT100R
U1, U2: 74LVC8T245; TSSOP-24_4.4x7.8mm_P0.65mm; MFG_PN 74LVC8T245PW,118
U3, U4: TCA9546A; TSSOP-16_4.4x5mm_P0.65mm; MFG_PN TCA9546APWR

Connections:
3V3: C33.1, C34.1, C35.1, C36.1, D1.2 (A), D3.2 (A), D5.2 (A), D7.2 (A), D9.2 (A), D11.2 (A), D13.2 (A), D15.2 (A), L1.1, L2.1, L3.1, L4.1, L5.1, L6.1, L7.1, L8.1, L9.1, L10.1, L11.1, L12.1, L13.1, L14.1, L15.1, L16.1, R1.2, R2.2, R3.2, R4.2, R5.2, R6.2, R7.2, R8.2, R9.2, R10.2, R11.2, R12.2, R13.2, R14.2, R15.2, R16.2, R17.2, R18.2, R19.2, R20.2, R21.2, R22.2, R23.2, R24.2, R25.2, R26.2, R27.2, R28.2, R29.2, R30.2, R31.2, R32.2, R33.2, R34.2, R35.2, R36.2, R37.2, R38.2, R39.2, R40.2, R41.2, R42.2, R43.2, R44.2, R45.2, R46.2, R47.2, R48.2, R49.1, R50.1, R51.1, R52.1, R69.1, R70.1, R71.1, R72.1, R73.1, R74.1, R75.1, R76.1, R77.1, R78.1, R79.1, R80.1, R81.1, R82.1, R83.1, R84.1, U1.1 (VCCA), U1.23 (VCCB), U1.24 (VCCB), U2.1 (VCCA), U2.23 (VCCB), U2.24 (VCCB), U3.16 (VCC), U4.16 (VCC)
/SFP/I2C0.SCL: U4.14 (SCL)
/SFP/I2C0.SDA: U4.15 (SDA)
/SFP/I2C.SCL: R49.2, U3.14 (SCL); also elsewhere on the board
/SFP/I2C.SDA: R50.2, U3.15 (SDA); also elsewhere on the board
/SFP/SCL0: J6.AL5 (SCL), R81.2, U3.12 (SC3)
/SFP/SCL1: J6.AT5 (SCL), R77.2, U3.10 (SC2)
/SFP/SCL2: J6.BL5 (SCL), J6.DL5 (SCL), R73.2, U3.7 (SC1)
/SFP/SCL3: J6.BT5 (SCL), J6.DT5 (SCL), R69.2, U3.5 (SC0)
/SFP/SCL4: J6.CL5 (SCL), R82.2, U4.12 (SC3)
/SFP/SCL5: J6.CT5 (SCL), R78.2, U4.10 (SC2)
/SFP/SCL6: R74.2, U4.7 (SC1)
/SFP/SCL7: R70.2, U4.5 (SC0)
/SFP/SDA0: J6.AL4 (SDA), R83.2, U3.11 (SD3)
/SFP/SDA1: J6.AT4 (SDA), R79.2, U3.9 (SD2)
/SFP/SDA2: J6.BL4 (SDA), J6.DL4 (SDA), R75.2, U3.6 (SD1)
/SFP/SDA3: J6.BT4 (SDA), J6.DT4 (SDA), R71.2, U3.4 (SD0)
/SFP/SDA4: J6.CL4 (SDA), R84.2, U4.11 (SD3)
/SFP/SDA5: J6.CT4 (SDA), R80.2, U4.9 (SD2)
/SFP/SDA6: R76.2, U4.6 (SD1)
/SFP/SDA7: R72.2, U4.4 (SD0)
/SFP/SFP0.RX_N: J6.AL12 (RD-); also elsewhere on the board
/SFP/SFP0.RX_P: J6.AL13 (RD+); also elsewhere on the board
/SFP/SFP0.TX_N: J6.AL19 (TD-); also elsewhere on the board
/SFP/SFP0.TX_P: J6.AL18 (TD+); also elsewhere on the board
/SFP/SFP1.RX_N: J6.AT12 (RD-); also elsewhere on the board
/SFP/SFP1.RX_P: J6.AT13 (RD+); also elsewhere on the board
/SFP/SFP1.TX_N: J6.AT19 (TD-); also elsewhere on the board
/SFP/SFP1.TX_P: J6.AT18 (TD+); also elsewhere on the board
/SFP/SFP2.RX_N: J6.BL12 (RD-); also elsewhere on the board
/SFP/SFP2.RX_P: J6.BL13 (RD+); also elsewhere on the board
/SFP/SFP2.TX_N: J6.BL19 (TD-); also elsewhere on the board
/SFP/SFP2.TX_P: J6.BL18 (TD+); also elsewhere on the board
/SFP/SFP3.RX_N: J6.BT12 (RD-); also elsewhere on the board
/SFP/SFP3.RX_P: J6.BT13 (RD+); also elsewhere on the board
/SFP/SFP3.TX_N: J6.BT19 (TD-); also elsewhere on the board
/SFP/SFP3.TX_P: J6.BT18 (TD+); also elsewhere on the board
/SFP/SFP4.RX_N: J6.CL12 (RD-); also elsewhere on the board
/SFP/SFP4.RX_P: J6.CL13 (RD+); also elsewhere on the board
/SFP/SFP4.TX_N: J6.CL19 (TD-); also elsewhere on the board
/SFP/SFP4.TX_P: J6.CL18 (TD+); also elsewhere on the board
/SFP/SFP5.RX_N: J6.CT12 (RD-); also elsewhere on the board
/SFP/SFP5.RX_P: J6.CT13 (RD+); also elsewhere on the board
/SFP/SFP5.TX_N: J6.CT19 (TD-); also elsewhere on the board
/SFP/SFP5.TX_P: J6.CT18 (TD+); also elsewhere on the board
/SFP/SFP6.RX_N: J6.DL12 (RD-); also elsewhere on the board
/SFP/SFP6.RX_P: J6.DL13 (RD+); also elsewhere on the board
/SFP/SFP6.TX_N: J6.DL19 (TD-); also elsewhere on the board
/SFP/SFP6.TX_P: J6.DL18 (TD+); also elsewhere on the board
/SFP/SFP7.RX_N: J6.DT12 (RD-); also elsewhere on the board
/SFP/SFP7.RX_P: J6.DT13 (RD+); also elsewhere on the board
/SFP/SFP7.TX_N: J6.DT19 (TD-); also elsewhere on the board
/SFP/SFP7.TX_P: J6.DT18 (TD+); also elsewhere on the board
/SFP/SFP_MOD_ABS0: D10.1 (K), J6.AL6 (MOD_ABS), R13.1; also elsewhere on the board
/SFP/SFP_MOD_ABS1: D12.1 (K), J6.AT6 (MOD_ABS), R14.1; also elsewhere on the board
/SFP/SFP_MOD_ABS2: D14.1 (K), J6.BL6 (MOD_ABS), R15.1; also elsewhere on the board
/SFP/SFP_MOD_ABS3: D16.1 (K), J6.BT6 (MOD_ABS), R16.1; also elsewhere on the board
/SFP/SFP_MOD_ABS4: D2.1 (K), J6.CL6 (MOD_ABS), R37.1; also elsewhere on the board
/SFP/SFP_MOD_ABS5: D4.1 (K), J6.CT6 (MOD_ABS), R38.1; also elsewhere on the board
/SFP/SFP_MOD_ABS6: D6.1 (K), J6.DL6 (MOD_ABS), R39.1; also elsewhere on the board
/SFP/SFP_MOD_ABS7: D8.1 (K), J6.DT6 (MOD_ABS), R40.1; also elsewhere on the board
/SFP/SFP_RX_LOS0: J6.AL8 (RX_LOS), R5.1, U2.20 (B2); also elsewhere on the board
/SFP/SFP_RX_LOS1: J6.AT8 (RX_LOS), R6.1, U2.18 (B4); also elsewhere on the board
/SFP/SFP_RX_LOS2: J6.BL8 (RX_LOS), R7.1, U2.16 (B6); also elsewhere on the board
/SFP/SFP_RX_LOS3: J6.BT8 (RX_LOS), R8.1, U2.14 (B8); also elsewhere on the board
/SFP/SFP_RX_LOS4: J6.CL8 (RX_LOS), R29.1, U1.20 (B2); also elsewhere on the board
/SFP/SFP_RX_LOS5: J6.CT8 (RX_LOS), R30.1, U1.18 (B4); also elsewhere on the board
/SFP/SFP_RX_LOS6: J6.DL8 (RX_LOS), R31.1, U1.16 (B6); also elsewhere on the board
/SFP/SFP_RX_LOS7: J6.DT8 (RX_LOS), R32.1, U1.14 (B8); also elsewhere on the board
/SFP/SFP_TX_DIS0: J6.AL3 (TX_DISABLE), R17.1, U2.21 (B1); also elsewhere on the board
/SFP/SFP_TX_DIS1: J6.AT3 (TX_DISABLE), R18.1, U2.19 (B3); also elsewhere on the board
/SFP/SFP_TX_DIS2: J6.BL3 (TX_DISABLE), R19.1, U2.17 (B5); also elsewhere on the board
/SFP/SFP_TX_DIS3: J6.BT3 (TX_DISABLE), R20.1, U2.15 (B7); also elsewhere on the board
/SFP/SFP_TX_DIS4: J6.CL3 (TX_DISABLE), R41.1, U1.21 (B1); also elsewhere on the board
/SFP/SFP_TX_DIS5: J6.CT3 (TX_DISABLE), R42.1, U1.19 (B3); also elsewhere on the board
/SFP/SFP_TX_DIS6: J6.DL3 (TX_DISABLE), R43.1, U1.17 (B5); also elsewhere on the board
/SFP/SFP_TX_DIS7: J6.DT3 (TX_DISABLE), R44.1, U1.15 (B7); also elsewhere on the board
GND: C1.1, C2.2, C3.1, C4.2, C5.1, C6.2, C7.1, C8.2, C9.2, C10.2, C11.2, C12.2, C13.2, C14.2, C15.2, C16.2, C17.1, C18.2, C19.1, C20.2, C21.1, C22.2, C23.1, C24.2, C25.2, C26.2, C27.2, C28.2, C29.2, C30.2, C31.2, C32.2, C33.2, C34.2, C35.2, C36.2, J6.AL1 (VeeT), J6.AL10 (VeeR), J6.AL11 (VeeR), J6.AL14 (VeeR), J6.AL17 (VeeT), J6.AL20 (VeeT), J6.AT1 (VeeT), J6.AT10 (VeeR), J6.AT11 (VeeR), J6.AT14 (VeeR), J6.AT17 (VeeT), J6.AT20 (VeeT), J6.BL1 (VeeT), J6.BL10 (VeeR), J6.BL11 (VeeR), J6.BL14 (VeeR), J6.BL17 (VeeT), J6.BL20 (VeeT), J6.BT1 (VeeT), J6.BT10 (VeeR), J6.BT11 (VeeR), J6.BT14 (VeeR), J6.BT17 (VeeT), J6.BT20 (VeeT), J6.CAGE, J6.CL1 (VeeT), J6.CL10 (VeeR), J6.CL11 (VeeR), J6.CL14 (VeeR), J6.CL17 (VeeT), J6.CL20 (VeeT), J6.CT1 (VeeT), J6.CT10 (VeeR), J6.CT11 (VeeR), J6.CT14 (VeeR), J6.CT17 (VeeT), J6.CT20 (VeeT), J6.DL1 (VeeT), J6.DL10 (VeeR), J6.DL11 (VeeR), J6.DL14 (VeeR), J6.DL17 (VeeT), J6.DL20 (VeeT), J6.DT1 (VeeT), J6.DT10 (VeeR), J6.DT11 (VeeR), J6.DT14 (VeeR), J6.DT17 (VeeT), J6.DT20 (VeeT), U1.2 (DIR), U1.11 (GND), U1.12 (GND), U1.13 (GND), U1.22 (~OE), U2.2 (DIR), U2.11 (GND), U2.12 (GND), U2.13 (GND), U2.22 (~OE), U3.1 (A0), U3.2 (A1), U3.8 (GND), U3.13 (A2), U4.1 (A0), U4.2 (A1), U4.8 (GND), U4.13 (A2); also elsewhere on the board
unnamed: D1.1 (K), R53.2
unnamed: D2.2 (A), R54.2
unnamed: D3.1 (K), R55.2
unnamed: D4.2 (A), R56.2
unnamed: D5.1 (K), R57.2
unnamed: D6.2 (A), R58.2
unnamed: D7.1 (K), R59.2
unnamed: D8.2 (A), R60.2
unnamed: D9.1 (K), R61.2
unnamed: D10.2 (A), R62.2
unnamed: D11.1 (K), R63.2
unnamed: D12.2 (A), R64.2
unnamed: D13.1 (K), R65.2
unnamed: D14.2 (A), R66.2
unnamed: D15.1 (K), R67.2
unnamed: D16.2 (A), R68.2
unnamed: J6.AL7 (RS0), R9.1
unnamed: J6.AL9 (RS1), R1.1
unnamed: J6.AL2 (TX_FAULT), R21.1
unnamed: C1.2, C9.1, J6.AL15 (VccR), L1.2
unnamed: C2.1, C10.1, J6.AL16 (VccT), L2.2
unnamed: J6.AT7 (RS0), R10.1
unnamed: J6.AT9 (RS1), R2.1
unnamed: J6.AT2 (TX_FAULT), R22.1
unnamed: C3.2, C11.1, J6.AT15 (VccR), L3.2
unnamed: C4.1, C12.1, J6.AT16 (VccT), L4.2
unnamed: J6.BL7 (RS0), R11.1
unnamed: J6.BL9 (RS1), R3.1
unnamed: J6.BL2 (TX_FAULT), R23.1
unnamed: C5.2, C13.1, J6.BL15 (VccR), L5.2
unnamed: C6.1, C14.1, J6.BL16 (VccT), L6.2
unnamed: J6.BT7 (RS0), R12.1
unnamed: J6.BT9 (RS1), R4.1
unnamed: J6.BT2 (TX_FAULT), R24.1
unnamed: C7.2, C15.1, J6.BT15 (VccR), L7.2
unnamed: C8.1, C16.1, J6.BT16 (VccT), L8.2
unnamed: J6.CL7 (RS0), R33.1
unnamed: J6.CL9 (RS1), R25.1
unnamed: J6.CL2 (TX_FAULT), R45.1
unnamed: C17.2, C25.1, J6.CL15 (VccR), L9.2
unnamed: C18.1, C26.1, J6.CL16 (VccT), L10.2
unnamed: J6.CT7 (RS0), R34.1
unnamed: J6.CT9 (RS1), R26.1
unnamed: J6.CT2 (TX_FAULT), R46.1
unnamed: C19.2, C27.1, J6.CT15 (VccR), L11.2
unnamed: C20.1, C28.1, J6.CT16 (VccT), L12.2
unnamed: J6.DL7 (RS0), R35.1
unnamed: J6.DL9 (RS1), R27.1
unnamed: J6.DL2 (TX_FAULT), R47.1
unnamed: C21.2, C29.1, J6.DL15 (VccR), L13.2
unnamed: C22.1, C30.1, J6.DL16 (VccT), L14.2
unnamed: J6.DT7 (RS0), R36.1
unnamed: J6.DT9 (RS1), R28.1
unnamed: J6.DT2 (TX_FAULT), R48.1
unnamed: C23.2, C31.1, J6.DT15 (VccR), L15.2
unnamed: C24.1, C32.1, J6.DT16 (VccT), L16.2
unnamed: R53.1, U1.3 (A1)
unnamed: R54.1, U1.4 (A2)
unnamed: R55.1, U1.5 (A3)
unnamed: R56.1, U1.6 (A4)
unnamed: R57.1, U1.7 (A5)
unnamed: R58.1, U1.8 (A6)
unnamed: R59.1, U1.9 (A7)
unnamed: R60.1, U1.10 (A8)
unnamed: R61.1, U2.3 (A1)
unnamed: R62.1, U2.4 (A2)
unnamed: R63.1, U2.5 (A3)
unnamed: R64.1, U2.6 (A4)
unnamed: R65.1, U2.7 (A5)
unnamed: R66.1, U2.8 (A6)
unnamed: R67.1, U2.9 (A7)
unnamed: R68.1, U2.10 (A8)
unnamed: R51.2, U3.3 (~RESET)
unnamed: R52.2, U4.3 (~RESET)

Notes on the sheet:
ADDR 0x50, 0x51
ADDR 0x70
FPGA pulls TX_DIS low to enable SFP (Turns on Green LED) MOD_ABS is pulled low when module installed RX_LOS is pulled high when optical power is too low RED LED goes on when MOD_ABS is low and RX_LOS is high

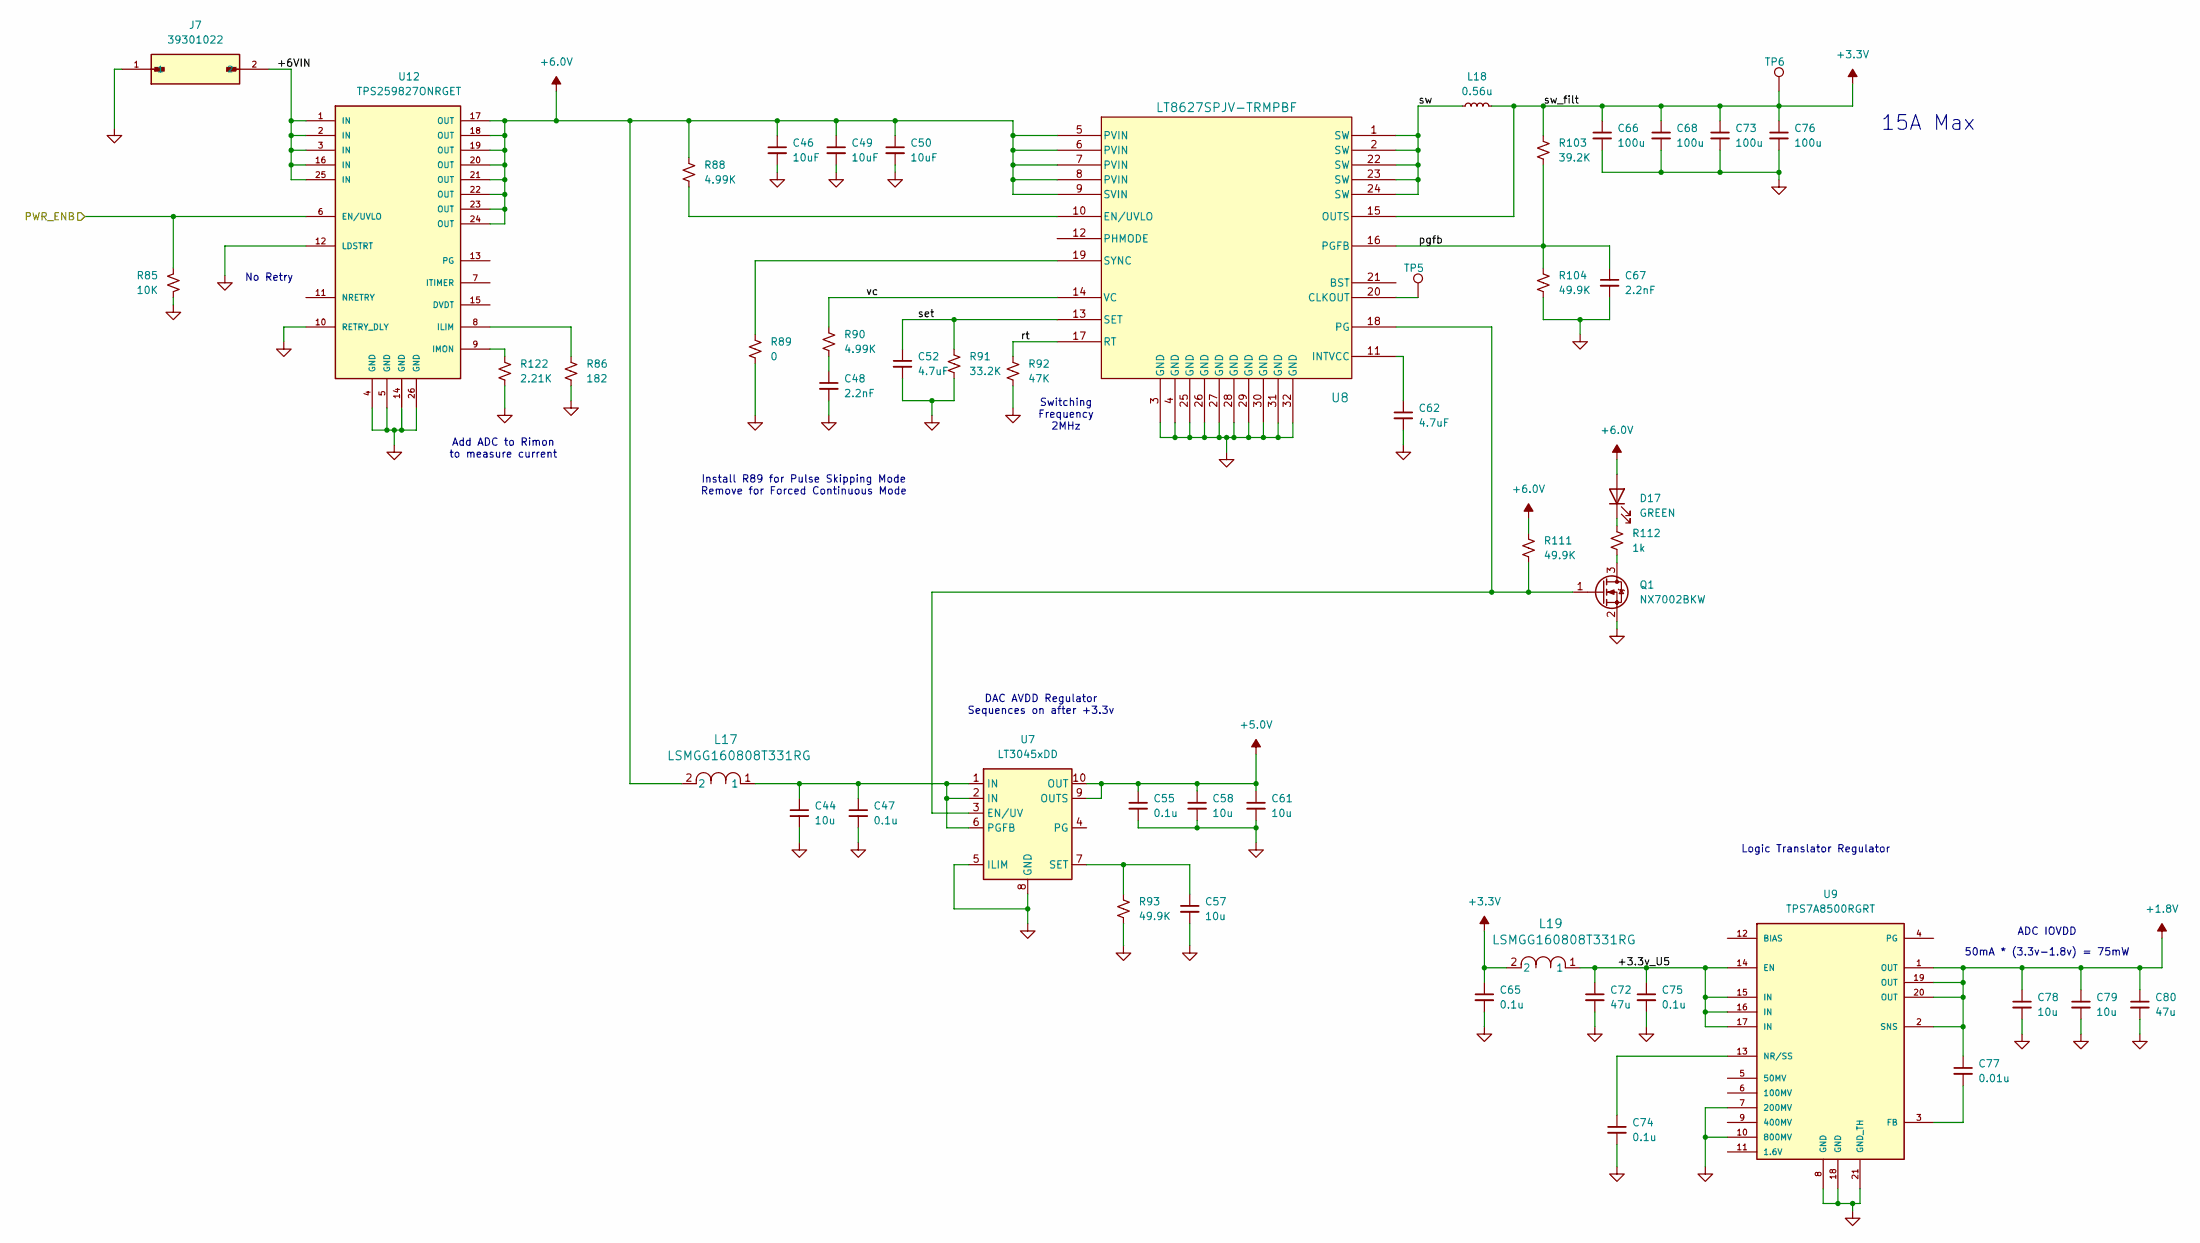
[picture p29: schematic regulator.kicad_sch]

Parts:
C44, C57, C58, C61, C78, C79: 10u; C_0805_2012Metric; MFG_PN GRM21BR61C106KE15K
C46, C49, C50: 10uF; C_0603_1608Metric; MFG_PN CL10A106MA8NRNC
C47, C55, C65, C74, C75: 0.1u; C_0805_2012Metric; MFG_PN TMF212B7104KGHT
C48, C67: 2.2nF; C_0603_1608Metric; MFG_PN GCJ188R71E102KA01D
C52: 4.7uF; C_1206_3216Metric; MFG_PN GCM31CR71C475KA37L
C62: 4.7uF; C_0603_1608Metric; MFG_PN GRM188Z71C475KE21D
C66, C68, C73, C76: 100u; C_0805_2012Metric; MFG_PN GRM21BR60J107ME15L
C72, C80: 47u; C_0805_2012Metric; MFG_PN C2012X5R1A476M125AC
C77: 0.01u; C_0805_2012Metric; MFG_PN MAASU21GSL8103MTNA01
D17: GREEN; LED_0603_1608Metric; MFG_PN LTST-C191KGKT
J7: 39301022; MOLEX_39301022; PARTREV A
L17, L19: LSMGG160808T331RG; IND_LSMG_160808_TAY; MFG_PN LSMGG160808T331RG
L18: 0.56u; COILCRAFT_XGL5050; MFG_PN XGL5050-561MEC
Q1: NX7002BKW; SOT-323_SC-70; MFG_PN NX7002BKWX
R85: 10K; R_0805_2012Metric; MFG_PN ERJ-2RKF1001X
R86: 182; R_0805_2012Metric; MFG_PN ERJ-6ENF4700V
R88, R90: 4.99K; R_0603_1608Metric; MFG_PN ERJ-3EKF4991V
R89: 0; R_0603_1608Metric; MFG_PN ERJ-3EKF4991V
R91: 33.2K; R_0603_1608Metric; MFG_PN ERJ-3EKF8661V
R92: 47K; R_0603_1608Metric; MFG_PN ERJ-3EKF4702V
R93: 49.9K; R_0805_2012Metric; MFG_PN ERJ-6ENF2053V
R103: 39.2K; R_0603_1608Metric; MFG_PN ERJ-3EKF3922V
R104, R111: 49.9K; R_0603_1608Metric; MFG_PN ERJ-3EKF4992V
R112: 1k; R_0603_1608Metric; MFG_PN ERJ-3EKF1001V
R122: 2.21K; R_0805_2012Metric; MFG_PN ERJ-6ENF4700V
TP5, TP6: ${SHORT_NET_NAME(1)}; TestPoint_THTPad_D2.0mm_Drill1.0mm
U7: LT3045xDD; DFN-10-1EP_3x3mm_P0.5mm_EP1.65x2.38mm
U8: LT8627SPJV-TRMPBF; 05-08-7039_ADI
U9: TPS7A8500RGRT; QFN50P350X350X100-21N; MFG_PN TPS7A8500RGRT
U12: TPS259827ONRGET; MFG_PN TPS259827ONRGET

Connections:
+1.8V: C77.1, C78.1, C79.1, C80.1, U9.1 (OUT), U9.2 (SNS), U9.19 (OUT), U9.20 (OUT); also elsewhere on the board
+3.3V: C65.1, C66.1, C68.1, C73.1, C76.1, L18.2, L19.2, R103.1, TP6.1, U8.15 (OUTS); also elsewhere on the board
+5.0V: C55.1, C58.1, C61.1, U7.9 (OUTS), U7.10 (OUT); also elsewhere on the board
+6.0V: C46.1, C49.1, C50.1, D17.2 (A), L17.2, R88.1, R111.1, U8.5 (PVIN), U8.6 (PVIN), U8.7 (PVIN), U8.8 (PVIN), U8.9 (SVIN), U12.17 (OUT), U12.18 (OUT), U12.19 (OUT), U12.20 (OUT), U12.21 (OUT), U12.22 (OUT), U12.23 (OUT), U12.24 (OUT)
/Regulators/+3.3v_U5: C72.1, C75.1, L19.1, U9.14 (EN), U9.15 (IN), U9.16 (IN), U9.17 (IN)
/Regulators/+6VIN: J7.2, U12.1 (IN), U12.2 (IN), U12.3 (IN), U12.16 (IN), U12.25 (IN)
/Regulators/PWR_ENB: R85.1, U12.6 (EN/UVLO); also elsewhere on the board
/Regulators/pgfb: C67.1, R103.2, R104.1, U8.16 (PGFB)
/Regulators/rt: R92.1, U8.17 (RT)
/Regulators/set: C52.1, R91.1, U8.13 (SET)
/Regulators/sw: L18.1, U8.1 (SW), U8.2 (SW), U8.22 (SW), U8.23 (SW), U8.24 (SW)
/Regulators/vc: R90.1, U8.14 (VC)
GND: C44.2, C46.2, C47.2, C48.2, C49.2, C50.2, C52.2, C55.2, C57.2, C58.2, C61.2, C62.2, C65.2, C66.2, C67.2, C68.2, C72.2, C73.2, C74.2, C75.2, C76.2, C78.2, C79.2, C80.2, J7.1, Q1.2 (S), R85.2, R86.2, R89.2, R91.2, R92.2, R93.2, R104.2, R122.2, U7.5 (ILIM), U7.8 (GND), U7.11 (GND), U8.3 (GND), U8.4 (GND), U8.25 (GND), U8.26 (GND), U8.27 (GND), U8.28 (GND), U8.29 (GND), U8.30 (GND), U8.31 (GND), U8.32 (GND), U9.7 (200MV), U9.8 (GND), U9.10 (800MV), U9.18 (GND), U9.21 (GND_TH), U12.4 (GND), U12.5 (GND), U12.10 (RETRY_DLY), U12.12 (LDSTRT), U12.14 (GND), U12.26 (GND); also elsewhere on the board
unnamed: C48.1, R90.2
unnamed: D17.1 (K), R112.1
unnamed: Q1.3 (D), R112.2
unnamed: Q1.1 (G), R111.2, U7.3 (EN/UV), U8.18 (PG)
unnamed: C44.1, C47.1, L17.1, U7.1 (IN), U7.2 (IN), U7.6 (PGFB)
unnamed: C57.1, R93.1, U7.7 (SET)
unnamed: TP5.1, U8.20 (CLKOUT)
unnamed: R88.2, U8.10 (EN/UVLO)
unnamed: C62.1, U8.11 (INTVCC)
unnamed: R89.1, U8.19 (SYNC)
unnamed: C77.2, U9.3 (FB)
unnamed: C74.1, U9.13 (NR/SS)
unnamed: R86.1, U12.8 (ILIM)
unnamed: R122.1, U12.9 (IMON)

Notes on the sheet:
No Retry
50mA * (3.3v-1.8v) = 75mW
DAC AVDD Regulator Sequences on after +3.3v
15A Max
ADC IOVDD
Switching Frequency 2MHz
Logic Translator Regulator
Install R89 for Pulse Skipping Mode Remove for Forced Continuous Mode
Add ADC to Rimon to measure current
