capotostobnl/cc-afe-hw/cc-afe.kicad_pcb

## KiCad design cc-afe.kicad_pcb (continued)

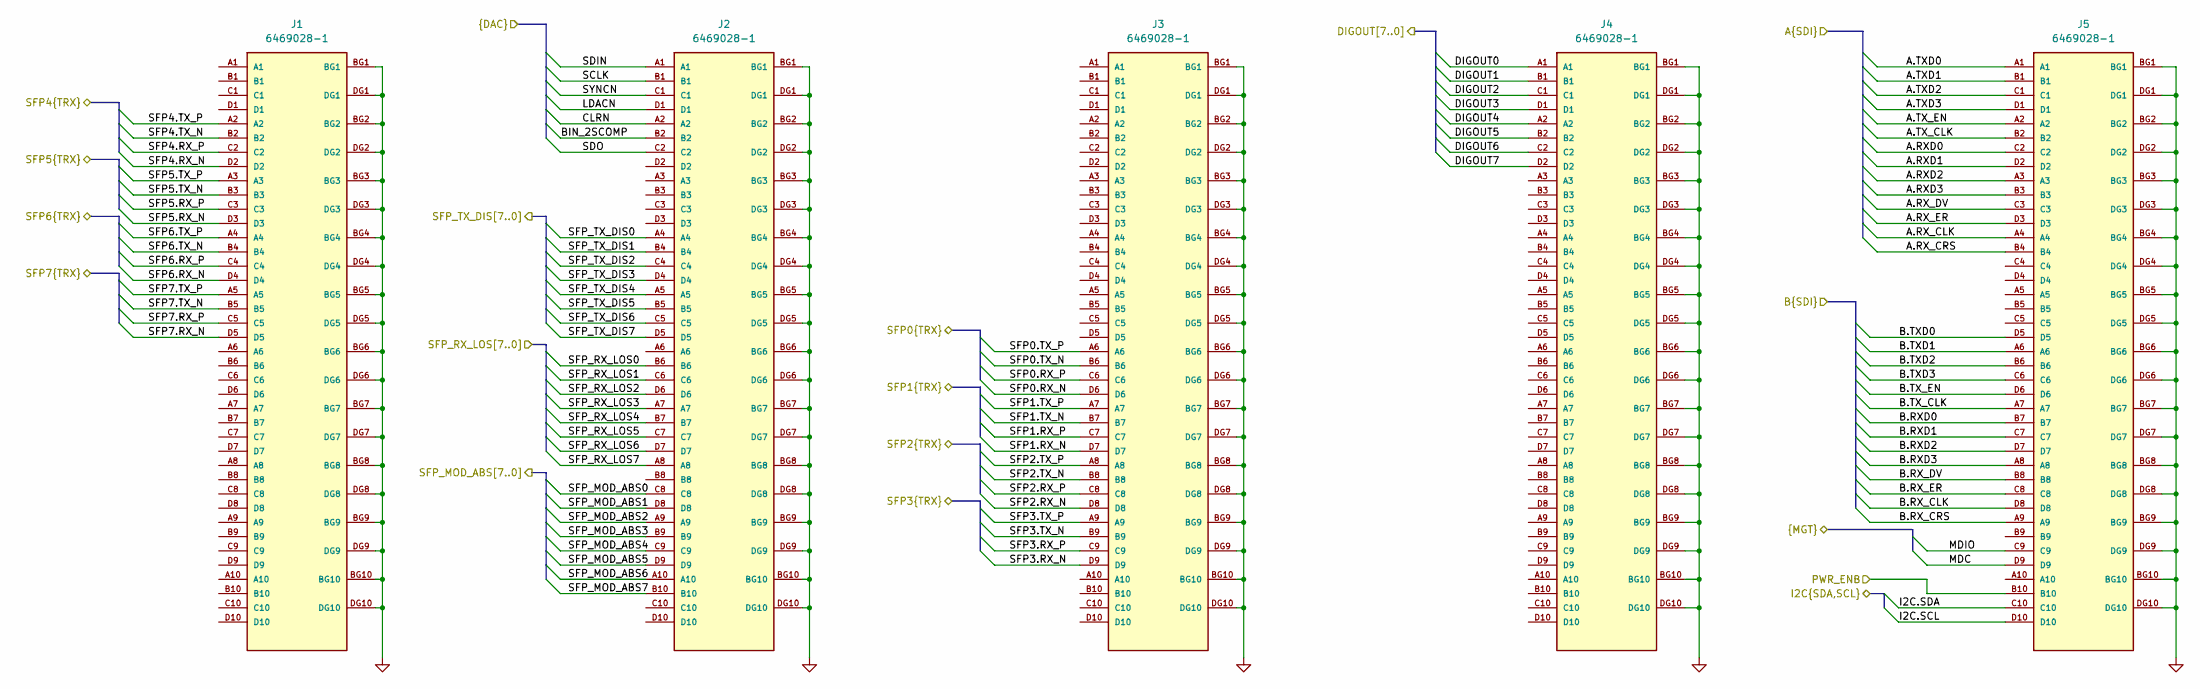
[picture p30: schematic zudfe_conn.kicad_sch]

Parts:
J1, J2, J3, J4, J5: 6469028-1; TE_6469028-1; PARTREV E

Connections:
/DAC/BIN_2SCOMP: J2.B2; also elsewhere on the board
/DAC/CLRN: J2.A2; also elsewhere on the board
/DAC/LDACN: J2.D1; also elsewhere on the board
/DAC/SCLK: J2.B1; also elsewhere on the board
/DAC/SDIN: J2.A1; also elsewhere on the board
/DAC/SDO: J2.C2
/DAC/SYNCN: J2.C1; also elsewhere on the board
/Digital Outputs/DIGOUT0: J4.A1; also elsewhere on the board
/Digital Outputs/DIGOUT1: J4.B1; also elsewhere on the board
/Digital Outputs/DIGOUT2: J4.C1; also elsewhere on the board
/Digital Outputs/DIGOUT3: J4.D1; also elsewhere on the board
/Digital Outputs/DIGOUT4: J4.A2; also elsewhere on the board
/Digital Outputs/DIGOUT5: J4.B2; also elsewhere on the board
/Digital Outputs/DIGOUT6: J4.C2; also elsewhere on the board
/Digital Outputs/DIGOUT7: J4.D2; also elsewhere on the board
/Regulators/PWR_ENB: J5.B10; also elsewhere on the board
/SDI/A.RXD0: J5.C2; also elsewhere on the board
/SDI/A.RXD1: J5.D2; also elsewhere on the board
/SDI/A.RXD2: J5.A3; also elsewhere on the board
/SDI/A.RXD3: J5.B3; also elsewhere on the board
/SDI/A.RX_CLK: J5.A4; also elsewhere on the board
/SDI/A.RX_CRS: J5.B4; also elsewhere on the board
/SDI/A.RX_DV: J5.C3; also elsewhere on the board
/SDI/A.RX_ER: J5.D3; also elsewhere on the board
/SDI/A.TXD0: J5.A1; also elsewhere on the board
/SDI/A.TXD1: J5.B1; also elsewhere on the board
/SDI/A.TXD2: J5.C1; also elsewhere on the board
/SDI/A.TXD3: J5.D1; also elsewhere on the board
/SDI/A.TX_CLK: J5.B2; also elsewhere on the board
/SDI/A.TX_EN: J5.A2; also elsewhere on the board
/SDI/B.RXD0: J5.B7; also elsewhere on the board
/SDI/B.RXD1: J5.C7; also elsewhere on the board
/SDI/B.RXD2: J5.D7; also elsewhere on the board
/SDI/B.RXD3: J5.A8; also elsewhere on the board
/SDI/B.RX_CLK: J5.D8; also elsewhere on the board
/SDI/B.RX_CRS: J5.A9; also elsewhere on the board
/SDI/B.RX_DV: J5.B8; also elsewhere on the board
/SDI/B.RX_ER: J5.C8; also elsewhere on the board
/SDI/B.TXD0: J5.D5; also elsewhere on the board
/SDI/B.TXD1: J5.A6; also elsewhere on the board
/SDI/B.TXD2: J5.B6; also elsewhere on the board
/SDI/B.TXD3: J5.C6; also elsewhere on the board
/SDI/B.TX_CLK: J5.A7; also elsewhere on the board
/SDI/B.TX_EN: J5.D6; also elsewhere on the board
/SDI/MDC: J5.D9; also elsewhere on the board
/SDI/MDIO: J5.C9; also elsewhere on the board
/SFP/I2C.SCL: J5.D10; also elsewhere on the board
/SFP/I2C.SDA: J5.C10; also elsewhere on the board
/SFP/SFP0.RX_N: J3.D6; also elsewhere on the board
/SFP/SFP0.RX_P: J3.C6; also elsewhere on the board
/SFP/SFP0.TX_N: J3.B6; also elsewhere on the board
/SFP/SFP0.TX_P: J3.A6; also elsewhere on the board
/SFP/SFP1.RX_N: J3.D7; also elsewhere on the board
/SFP/SFP1.RX_P: J3.C7; also elsewhere on the board
/SFP/SFP1.TX_N: J3.B7; also elsewhere on the board
/SFP/SFP1.TX_P: J3.A7; also elsewhere on the board
/SFP/SFP2.RX_N: J3.D8; also elsewhere on the board
/SFP/SFP2.RX_P: J3.C8; also elsewhere on the board
/SFP/SFP2.TX_N: J3.B8; also elsewhere on the board
/SFP/SFP2.TX_P: J3.A8; also elsewhere on the board
/SFP/SFP3.RX_N: J3.D9; also elsewhere on the board
/SFP/SFP3.RX_P: J3.C9; also elsewhere on the board
/SFP/SFP3.TX_N: J3.B9; also elsewhere on the board
/SFP/SFP3.TX_P: J3.A9; also elsewhere on the board
/SFP/SFP4.RX_N: J1.D2; also elsewhere on the board
/SFP/SFP4.RX_P: J1.C2; also elsewhere on the board
/SFP/SFP4.TX_N: J1.B2; also elsewhere on the board
/SFP/SFP4.TX_P: J1.A2; also elsewhere on the board
/SFP/SFP5.RX_N: J1.D3; also elsewhere on the board
/SFP/SFP5.RX_P: J1.C3; also elsewhere on the board
/SFP/SFP5.TX_N: J1.B3; also elsewhere on the board
/SFP/SFP5.TX_P: J1.A3; also elsewhere on the board
/SFP/SFP6.RX_N: J1.D4; also elsewhere on the board
/SFP/SFP6.RX_P: J1.C4; also elsewhere on the board
/SFP/SFP6.TX_N: J1.B4; also elsewhere on the board
/SFP/SFP6.TX_P: J1.A4; also elsewhere on the board
/SFP/SFP7.RX_N: J1.D5; also elsewhere on the board
/SFP/SFP7.RX_P: J1.C5; also elsewhere on the board
/SFP/SFP7.TX_N: J1.B5; also elsewhere on the board
/SFP/SFP7.TX_P: J1.A5; also elsewhere on the board
/SFP/SFP_MOD_ABS0: J2.C8; also elsewhere on the board
/SFP/SFP_MOD_ABS1: J2.D8; also elsewhere on the board
/SFP/SFP_MOD_ABS2: J2.A9; also elsewhere on the board
/SFP/SFP_MOD_ABS3: J2.B9; also elsewhere on the board
/SFP/SFP_MOD_ABS4: J2.C9; also elsewhere on the board
/SFP/SFP_MOD_ABS5: J2.D9; also elsewhere on the board
/SFP/SFP_MOD_ABS6: J2.A10; also elsewhere on the board
/SFP/SFP_MOD_ABS7: J2.B10; also elsewhere on the board
/SFP/SFP_RX_LOS0: J2.B6; also elsewhere on the board
/SFP/SFP_RX_LOS1: J2.C6; also elsewhere on the board
/SFP/SFP_RX_LOS2: J2.D6; also elsewhere on the board
/SFP/SFP_RX_LOS3: J2.A7; also elsewhere on the board
/SFP/SFP_RX_LOS4: J2.B7; also elsewhere on the board
/SFP/SFP_RX_LOS5: J2.C7; also elsewhere on the board
/SFP/SFP_RX_LOS6: J2.D7; also elsewhere on the board
/SFP/SFP_RX_LOS7: J2.A8; also elsewhere on the board
/SFP/SFP_TX_DIS0: J2.A4; also elsewhere on the board
/SFP/SFP_TX_DIS1: J2.B4; also elsewhere on the board
/SFP/SFP_TX_DIS2: J2.C4; also elsewhere on the board
/SFP/SFP_TX_DIS3: J2.D4; also elsewhere on the board
/SFP/SFP_TX_DIS4: J2.A5; also elsewhere on the board
/SFP/SFP_TX_DIS5: J2.B5; also elsewhere on the board
/SFP/SFP_TX_DIS6: J2.C5; also elsewhere on the board
/SFP/SFP_TX_DIS7: J2.D5; also elsewhere on the board
GND: J1.BG1, J1.BG2, J1.BG3, J1.BG4, J1.BG5, J1.BG6, J1.BG7, J1.BG8, J1.BG9, J1.BG10, J1.DG1, J1.DG2, J1.DG3, J1.DG4, J1.DG5, J1.DG6, J1.DG7, J1.DG8, J1.DG9, J1.DG10, J2.BG1, J2.BG2, J2.BG3, J2.BG4, J2.BG5, J2.BG6, J2.BG7, J2.BG8, J2.BG9, J2.BG10, J2.DG1, J2.DG2, J2.DG3, J2.DG4, J2.DG5, J2.DG6, J2.DG7, J2.DG8, J2.DG9, J2.DG10, J3.BG1, J3.BG2, J3.BG3, J3.BG4, J3.BG5, J3.BG6, J3.BG7, J3.BG8, J3.BG9, J3.BG10, J3.DG1, J3.DG2, J3.DG3, J3.DG4, J3.DG5, J3.DG6, J3.DG7, J3.DG8, J3.DG9, J3.DG10, J4.BG1, J4.BG2, J4.BG3, J4.BG4, J4.BG5, J4.BG6, J4.BG7, J4.BG8, J4.BG9, J4.BG10, J4.DG1, J4.DG2, J4.DG3, J4.DG4, J4.DG5, J4.DG6, J4.DG7, J4.DG8, J4.DG9, J4.DG10, J5.BG1, J5.BG2, J5.BG3, J5.BG4, J5.BG5, J5.BG6, J5.BG7, J5.BG8, J5.BG9, J5.BG10, J5.DG1, J5.DG2, J5.DG3, J5.DG4, J5.DG5, J5.DG6, J5.DG7, J5.DG8, J5.DG9, J5.DG10; also elsewhere on the board

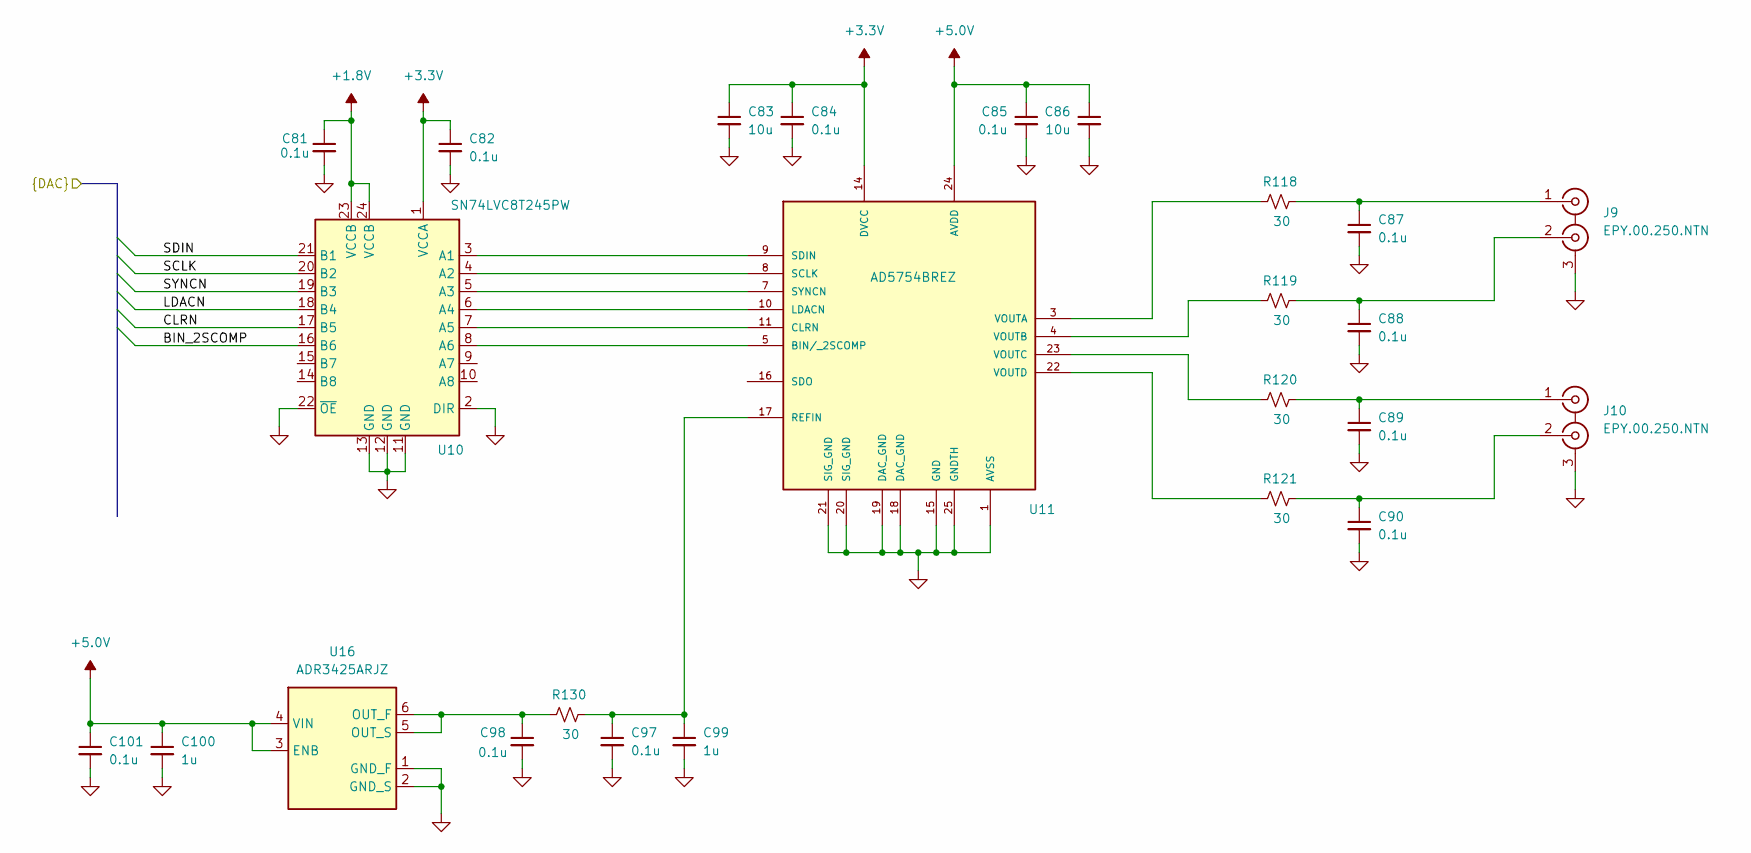
[picture p31: schematic dac.kicad_sch]

Parts:
C81, C82, C84, C85, C87, C88, C89, C90, C97, C98, C101: 0.1u; C_0603_1608Metric; Voltage 50; MFG_PN GCJ188R71H104KA12D
C83, C86: 10u; C_0805_2012Metric; MFG_PN GRM21BR61C106KE15K
C99, C100: 1u; C_0603_1608Metric; Voltage 50
J9, J10: EPY.00.250.NTN; LEMO_EPY.00.250.NTN; MFG_PN EPY.00.250.NTN
R118, R119, R120, R121, R130: 30; R_0603_1608Metric
U10: SN74LVC8T245PW; TSSOP-24_4.4x7.8mm_P0.65mm
U11: AD5754BREZ; SOP65P640X120-25N; MFG_PN AD5754BREZ
U16: ADR3425ARJZ; SOT95P280X145-6N; MFG_PN ADR3425ARJZ

Connections:
+1.8V: C81.1, U10.23 (VCCB), U10.24 (VCCB); also elsewhere on the board
+3.3V: C82.1, C83.1, C84.1, U10.1 (VCCA), U11.14 (DVCC); also elsewhere on the board
+5.0V: C85.1, C86.1, C100.1, C101.1, U11.24 (AVDD), U16.3 (ENB), U16.4 (VIN); also elsewhere on the board
/DAC/BIN_2SCOMP: U10.16 (B6); also elsewhere on the board
/DAC/CLRN: U10.17 (B5); also elsewhere on the board
/DAC/LDACN: U10.18 (B4); also elsewhere on the board
/DAC/SCLK: U10.20 (B2); also elsewhere on the board
/DAC/SDIN: U10.21 (B1); also elsewhere on the board
/DAC/SYNCN: U10.19 (B3); also elsewhere on the board
GND: C81.2, C82.2, C83.2, C84.2, C85.2, C86.2, C87.2, C88.2, C89.2, C90.2, C97.2, C98.2, C99.2, C100.2, C101.2, J9.3 (EXT), J10.3 (EXT), U10.2 (DIR), U10.11 (GND), U10.12 (GND), U10.13 (GND), U10.22 (~OE), U11.1 (AVSS), U11.15 (GND), U11.18 (DAC_GND), U11.19 (DAC_GND), U11.20 (SIG_GND), U11.21 (SIG_GND), U11.25 (GNDTH), U16.1 (GND_F), U16.2 (GND_S); also elsewhere on the board
unnamed: C87.1, J9.1 (IN1), R118.2
unnamed: C88.1, J9.2 (IN2), R119.2
unnamed: C89.1, J10.1 (IN1), R120.2
unnamed: C90.1, J10.2 (IN2), R121.2
unnamed: U10.3 (A1), U11.9 (SDIN)
unnamed: U10.4 (A2), U11.8 (SCLK)
unnamed: U10.5 (A3), U11.7 (SYNCN)
unnamed: U10.6 (A4), U11.10 (LDACN)
unnamed: U10.7 (A5), U11.11 (CLRN)
unnamed: U10.8 (A6), U11.5 (BIN/_2SCOMP)
unnamed: C97.1, C99.1, R130.2, U11.17 (REFIN)
unnamed: R118.1, U11.3 (VOUTA)
unnamed: R119.1, U11.4 (VOUTB)
unnamed: R120.1, U11.23 (VOUTC)
unnamed: R121.1, U11.22 (VOUTD)
unnamed: C98.1, R130.1, U16.5 (OUT_S), U16.6 (OUT_F)

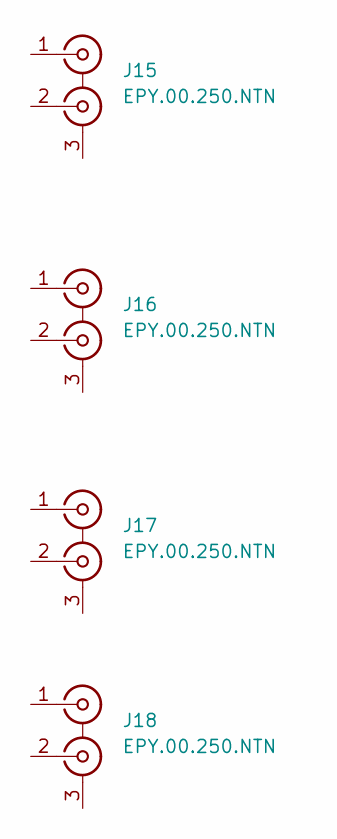
[picture p32: schematic digin.kicad_sch]

Parts:
J15, J16, J17, J18: EPY.00.250.NTN; LEMO_EPY.00.250.NTN; MFG_PN EPY.00.250.NTN

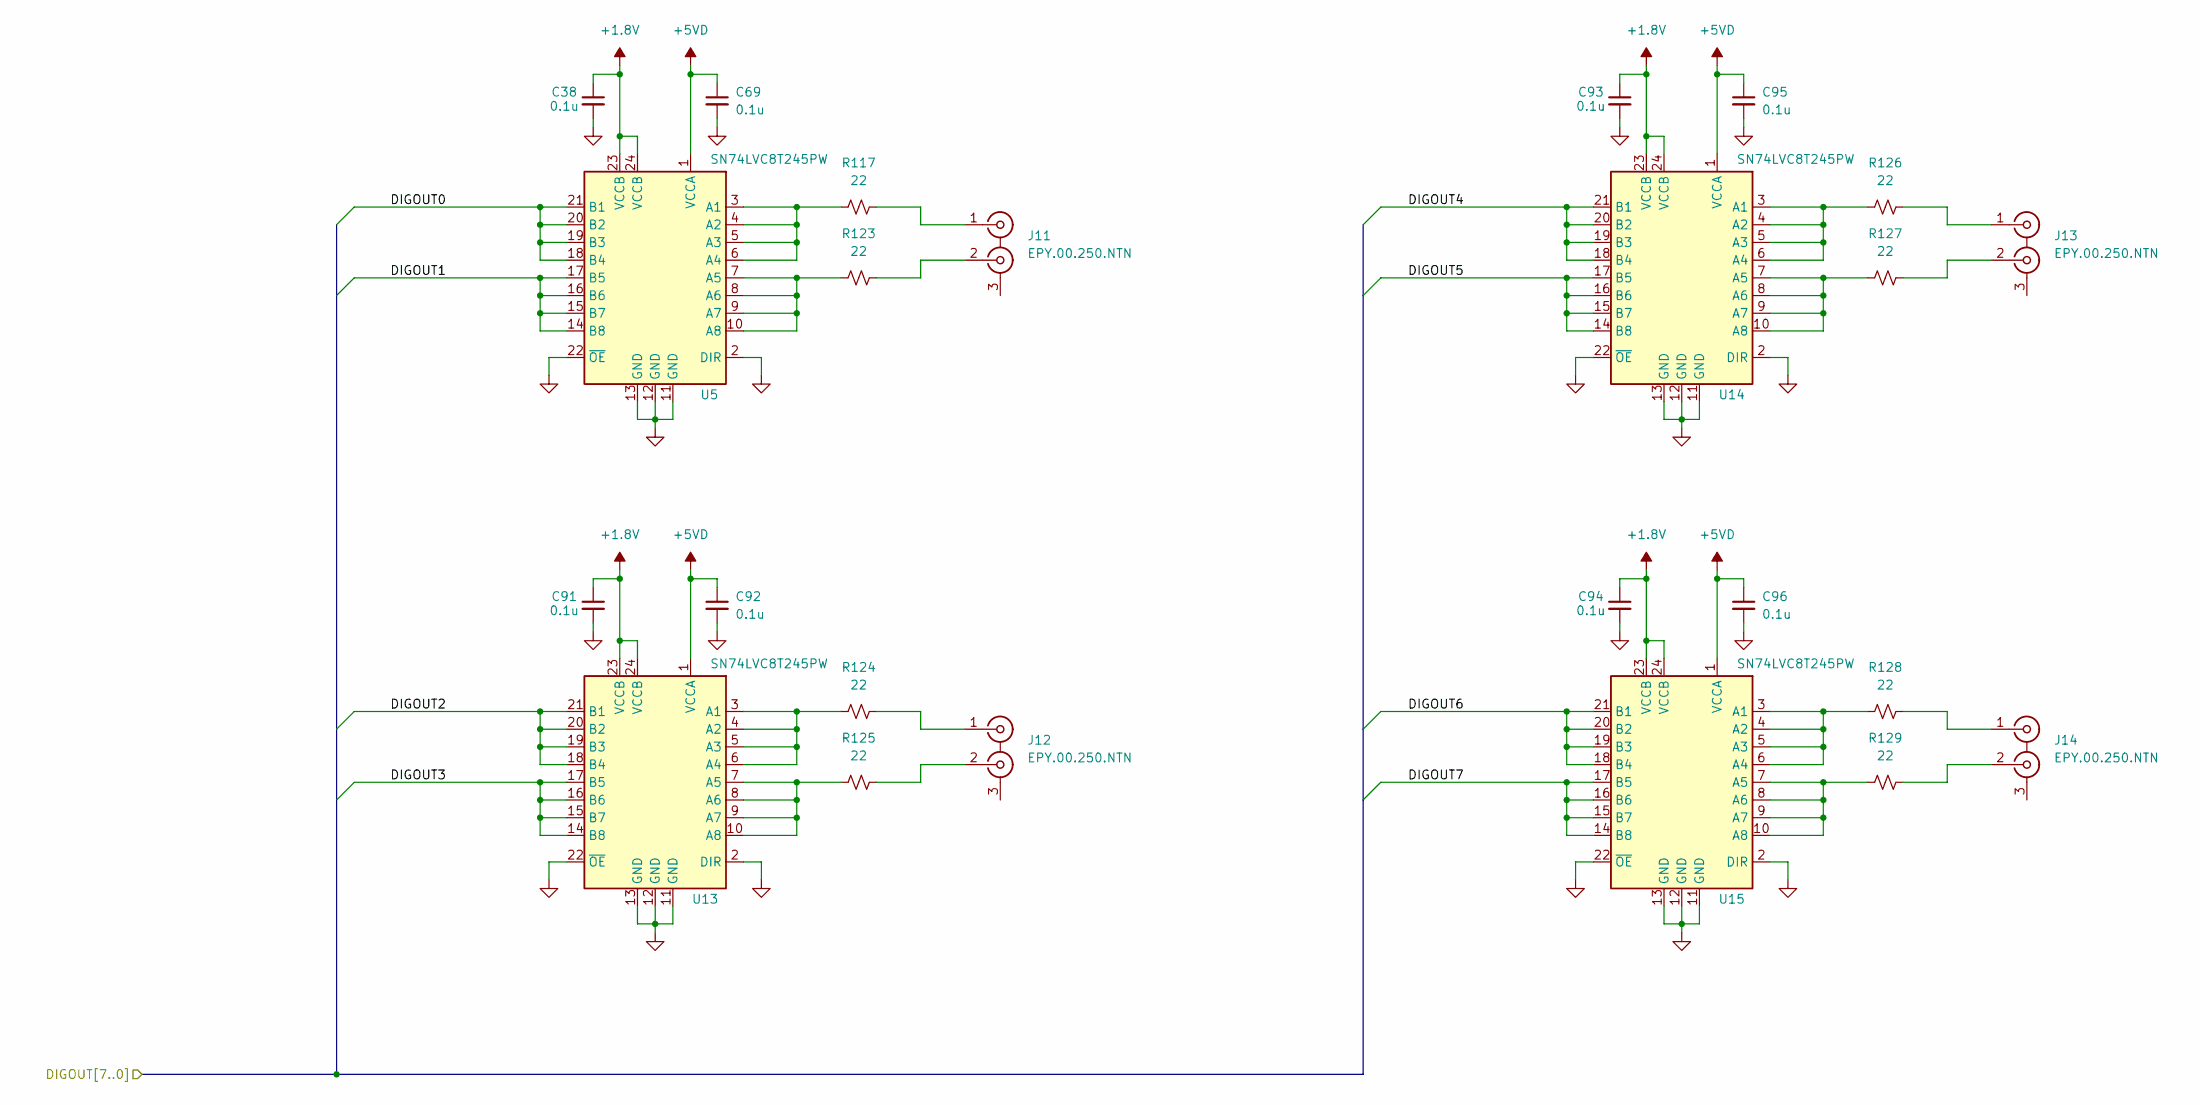
[picture p33: schematic digout.kicad_sch]

Parts:
C38, C69, C91, C92, C93, C94, C95, C96: 0.1u; C_0603_1608Metric; Voltage 50; MFG_PN GCJ188R71H104KA12D
J11, J12, J13, J14: EPY.00.250.NTN; LEMO_EPY.00.250.NTN; MFG_PN EPY.00.250.NTN
R117, R123, R124, R125, R126, R127, R128, R129: 22; R_1206_3216Metric; MFG_PN ERJ-3EKF49R9V
U5, U13, U14, U15: SN74LVC8T245PW; TSSOP-24_4.4x7.8mm_P0.65mm

Connections:
+1.8V: C38.1, C91.1, C93.1, C94.1, U5.23 (VCCB), U5.24 (VCCB), U13.23 (VCCB), U13.24 (VCCB), U14.23 (VCCB), U14.24 (VCCB), U15.23 (VCCB), U15.24 (VCCB); also elsewhere on the board
+5VD: C69.1, C92.1, C95.1, C96.1, U5.1 (VCCA), U13.1 (VCCA), U14.1 (VCCA), U15.1 (VCCA)
/Digital Outputs/DIGOUT0: U5.18 (B4), U5.19 (B3), U5.20 (B2), U5.21 (B1); also elsewhere on the board
/Digital Outputs/DIGOUT1: U5.14 (B8), U5.15 (B7), U5.16 (B6), U5.17 (B5); also elsewhere on the board
/Digital Outputs/DIGOUT2: U13.18 (B4), U13.19 (B3), U13.20 (B2), U13.21 (B1); also elsewhere on the board
/Digital Outputs/DIGOUT3: U13.14 (B8), U13.15 (B7), U13.16 (B6), U13.17 (B5); also elsewhere on the board
/Digital Outputs/DIGOUT4: U14.18 (B4), U14.19 (B3), U14.20 (B2), U14.21 (B1); also elsewhere on the board
/Digital Outputs/DIGOUT5: U14.14 (B8), U14.15 (B7), U14.16 (B6), U14.17 (B5); also elsewhere on the board
/Digital Outputs/DIGOUT6: U15.18 (B4), U15.19 (B3), U15.20 (B2), U15.21 (B1); also elsewhere on the board
/Digital Outputs/DIGOUT7: U15.14 (B8), U15.15 (B7), U15.16 (B6), U15.17 (B5); also elsewhere on the board
GND: C38.2, C69.2, C91.2, C92.2, C93.2, C94.2, C95.2, C96.2, U5.2 (DIR), U5.11 (GND), U5.12 (GND), U5.13 (GND), U5.22 (~OE), U13.2 (DIR), U13.11 (GND), U13.12 (GND), U13.13 (GND), U13.22 (~OE), U14.2 (DIR), U14.11 (GND), U14.12 (GND), U14.13 (GND), U14.22 (~OE), U15.2 (DIR), U15.11 (GND), U15.12 (GND), U15.13 (GND), U15.22 (~OE); also elsewhere on the board
unnamed: J11.1 (IN1), R117.2
unnamed: J11.2 (IN2), R123.2
unnamed: J12.1 (IN1), R124.2
unnamed: J12.2 (IN2), R125.2
unnamed: J13.1 (IN1), R126.2
unnamed: J13.2 (IN2), R127.2
unnamed: J14.1 (IN1), R128.2
unnamed: J14.2 (IN2), R129.2
unnamed: R117.1, U5.3 (A1), U5.4 (A2), U5.5 (A3), U5.6 (A4)
unnamed: R123.1, U5.7 (A5), U5.8 (A6), U5.9 (A7), U5.10 (A8)
unnamed: R124.1, U13.3 (A1), U13.4 (A2), U13.5 (A3), U13.6 (A4)
unnamed: R125.1, U13.7 (A5), U13.8 (A6), U13.9 (A7), U13.10 (A8)
unnamed: R126.1, U14.3 (A1), U14.4 (A2), U14.5 (A3), U14.6 (A4)
unnamed: R127.1, U14.7 (A5), U14.8 (A6), U14.9 (A7), U14.10 (A8)
unnamed: R128.1, U15.3 (A1), U15.4 (A2), U15.5 (A3), U15.6 (A4)
unnamed: R129.1, U15.7 (A5), U15.8 (A6), U15.9 (A7), U15.10 (A8)

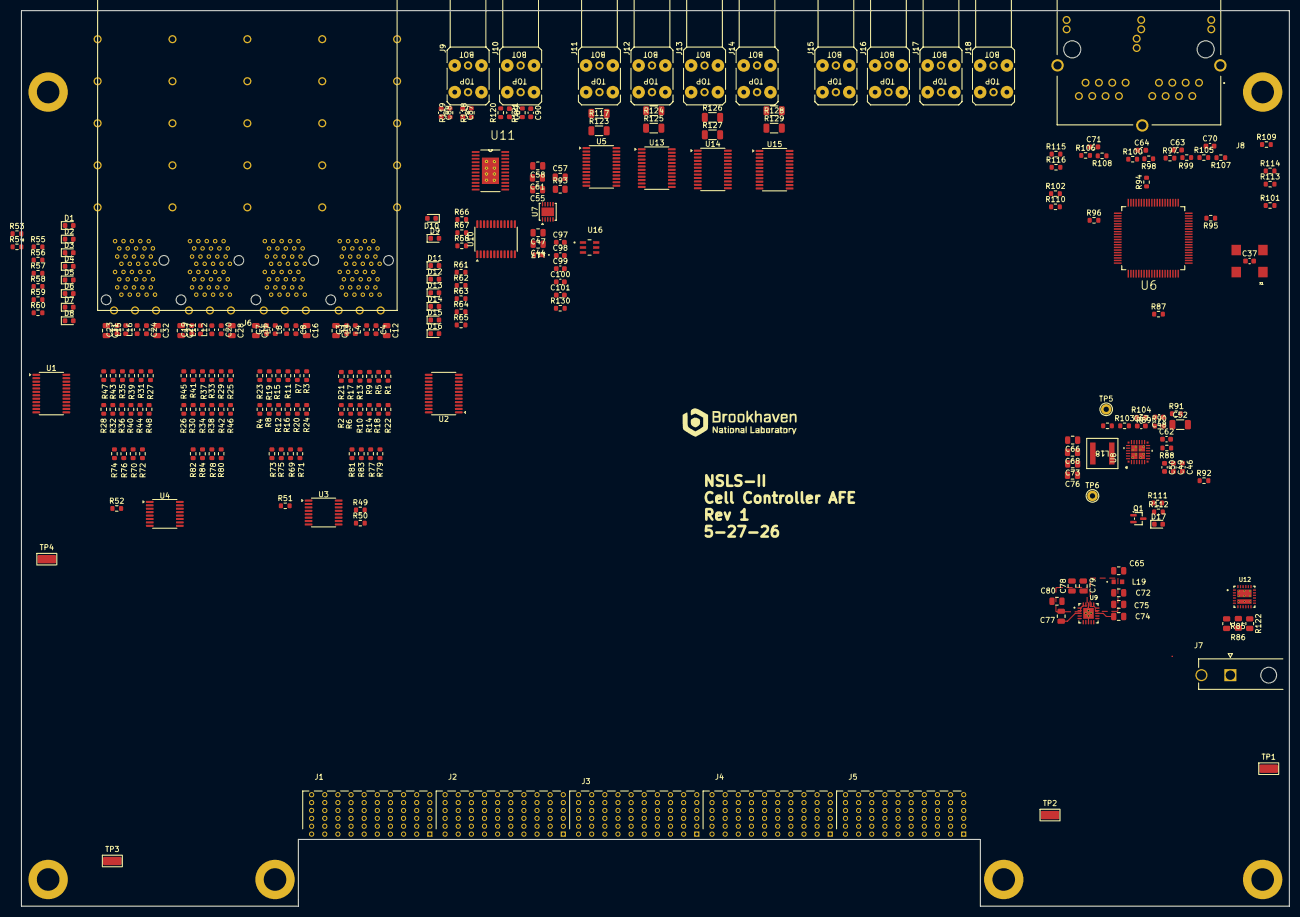
[picture p34: board cc-afe.kicad_pcb from above]

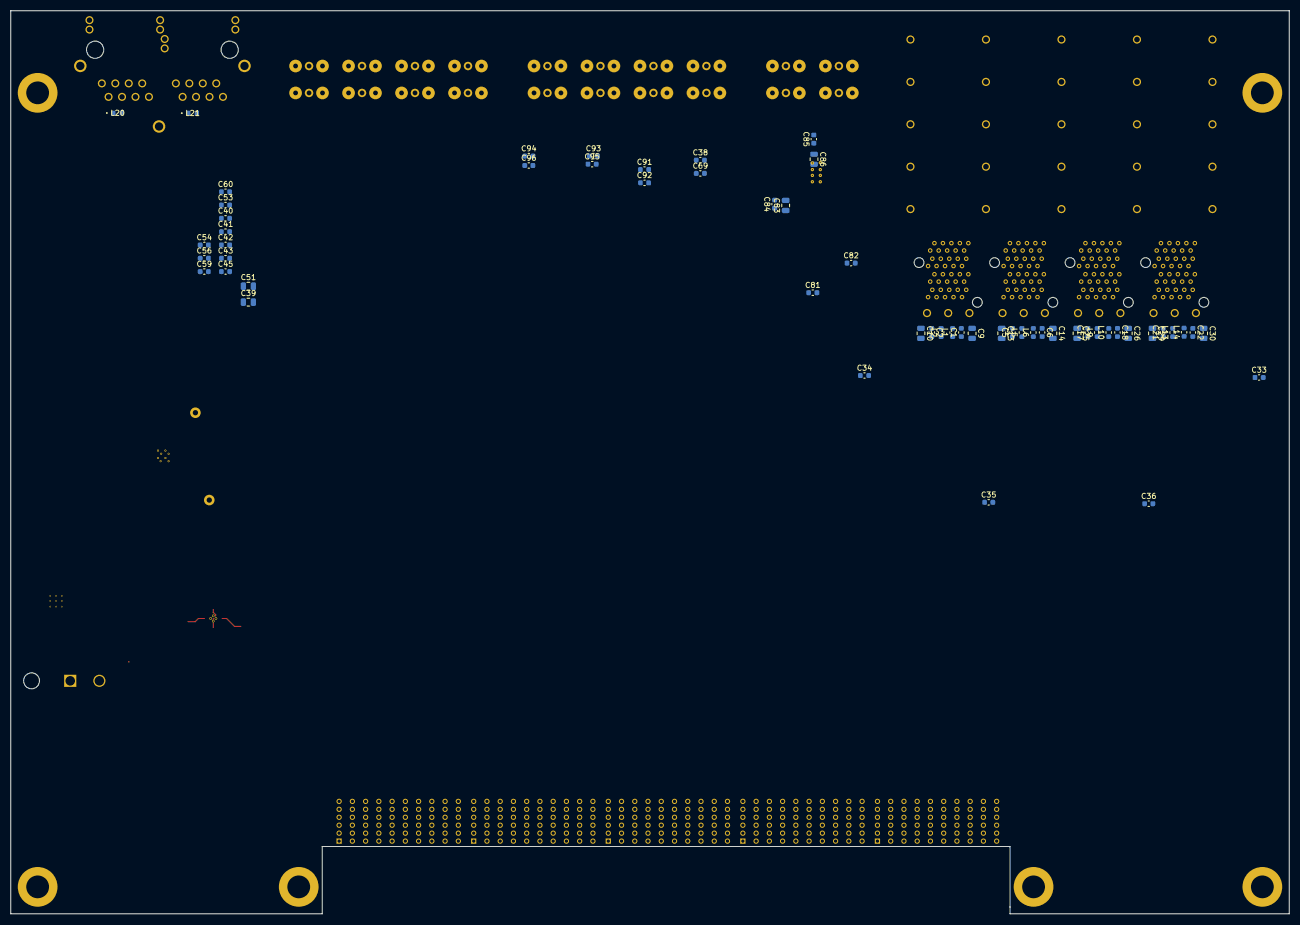
[picture p35: board cc-afe.kicad_pcb from below]

Board: 6 copper layers, 241.3 x 170.4 mm, 317 parts (56 on the bottom side), 280 nets.
