capotostobnl/cc-afe-hw/(commit log)

2026-06-03 Finish Regulator section
    [AD5754BREZ.STEP, LEMO_EPY_00_250_NTN.stp, TPS259827ONRGET.step, cc-afe.kicad_pcb, cc-afe.kicad_sch, dac.kicad_sch, regulator.kicad_sch, sdi.kicad_sch]
2026-06-04 Place SFP passives
    [cc-afe.kicad_pcb, cc-afe.kicad_sch, regulator.kicad_sch, sdi.kicad_sch, sfp.kicad_sch, zudfe_conn.kicad_sch]
2026-06-04 Remove more unused schematics
    [Fault_leds.kicad_sch, adc.kicad_sch]
2026-06-05 Add digital Outputs
    [ADR3425ARJZ-R2.step, cc-afe.kicad_pcb, cc-afe.kicad_sch, dac.kicad_sch, digin.kicad_sch, digout.kicad_sch, zudfe_conn.kicad_sch]
